Lucboulesteix/TinyRISC/README.md

# TinyRISC
 TINYRISC is a project to design and build an 8-bit computer using discrete logic components
 See "descriptive document.docx" for technical information
