Lucboulesteix/TinyRISC/Diagrams/High level/aludecode.png

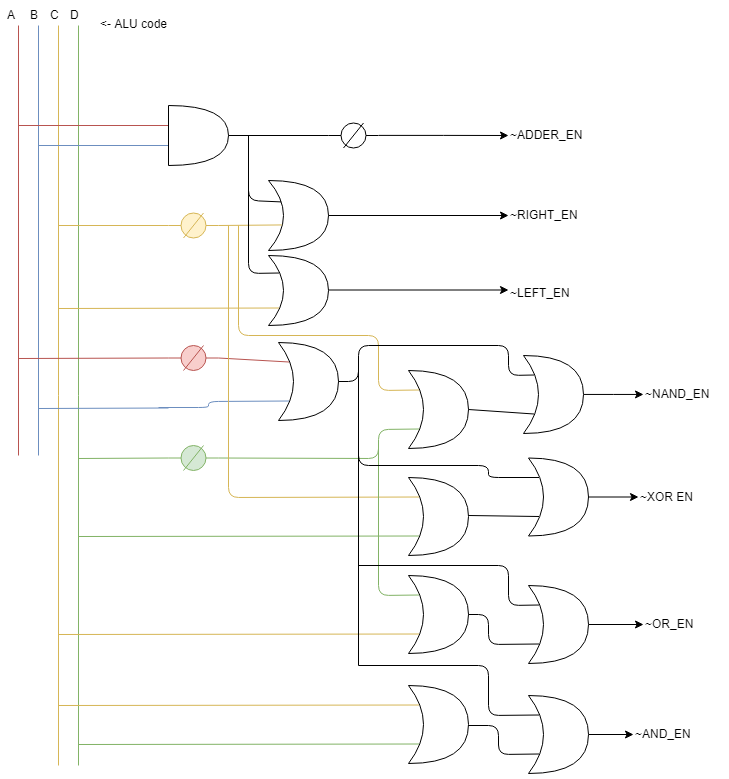
Diagrams/High level/aludecode.png
