Lucboulesteix/TinyRISC/Program Counter/v1.1/Images/PC finished view.png

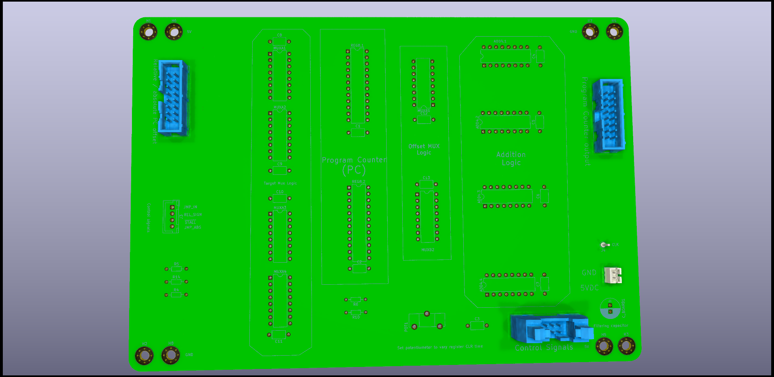
Program Counter/v1.1/Images/PC finished view.png
