Lucboulesteix/TinyRISC/BOM.xlsx

ALU |  | ALU
Id | Designator | Package | Quantity | Designation | Supplier and ref | Bought | Per unit Price | Total price
1 | XOR42,XOR41,XOR4,XOR3,XOR2,XOR1,XOR0 | DIP-14_W7.62mm | 7 | 74F86 | Mouser (https://www.mouser.fr/ProductDetail/Texas-Instruments/SN74F86N?qs=OorDGPQ79EqAoC7T7cW4HA%3D%3D) | 10 | 0.513 | 5.13
2 | 5V/GND1 | JST_XH_B02B-XH-A_02x2.50mm_Straight | 1 | Conn_01x02_Male |  |  |  | 0.00
3 | XOR_GATE0,SR_GATE0,SL_GATE0,OR_GATE1,NAND_GATE0,FlagsRight1,FlagsLogical1,FlagsLeft1,FlagsAdd0,AND_GATE1,ADD_GATE1,ADD_GATE0 | DIP-20_W7.62mm | 12 | 74F245 | Mouser (https://www.mouser.fr/ProductDetail/Texas-Instruments/SN74F245N?qs=p6YqzpSxLIwRRuS%252BxgbuIQ%3D%3D) | 13 | 0.898 | 11.67
4 | PDB15,PDB14,PDB13,PDB12,PDB11,PDB10,PDB9,PDB8,PD15,PD14,PD13,PD12,PD11,PD10,PD9,PD8 | R_Axial_DIN0204_L3.6mm_D1.6mm_P7.62mm_Horizontal | 16 | 10k | https://www.mouser.fr/ProductDetail/YAGEO/CFR-50JR-52-10K | 100 | 0.024 | 2.40
5 | OR1,OR0,DECODEROR0,DECODEOR2,DECODEOR1 | DIP-14_W7.62mm | 5 | 74F32 | Mouser (https://www.mouser.fr/ProductDetail/Texas-Instruments/SN74F32N?qs=mE33ZKBHyE7y%252BJhxkbFiog%3D%3D) | 6 | 0.601 | 3.61
6 | OP2,OP1,ALU_OUT1 | 16pinIDC | 3 | Conn_01x16_Male | Mouser (https://www.mouser.fr/ProductDetail/HARTING/09195167324?qs=Afqhj6cPmO%2FZprUhRABW%252Bw%3D%3D) |  | 2.22 | 0.00
7 | NAND1,NAND0 | DIP-14_W7.62mm | 2 | 74F00 | Mouser (https://www.mouser.fr/ProductDetail/Texas-Instruments/SN74F00N?qs=6gY4t2uohMypkE3htptVwQ%3D%3D) | 3 | 0.559 | 1.68
8 | MUXCout1 | DIP-16_W7.62mm | 1 | 74F257 | https://www.mouser.fr/ProductDetail/Texas-Instruments/SN74F257N?qs=mE33ZKBHyE5hYlcdl%2FU8vg%3D%3D | 8 | 0.69 | 5.52
9 | H8,H7,H6,H4 | MountingHole_3.5mm_Pad_Via | 4 | MountingHole
10 | H5,H3,H2,H1 | MountingHole_3.5mm_Pad_Via | 4 | MountingHole_Pad
11 | FLAGS_OUT1,ALU_COMM1 | 6 pin IDC | 2 | Conn_01x06_Male | https://www.mouser.fr/ProductDetail/HARTING/09185067904?qs=6AJYfC4azShOZEhCahhORg%3D%3D |  | 1.42 | 0.00
12 | DECODENOT0 | DIP-14_W7.62mm | 1 | 74F04 | https://www.mouser.fr/ProductDetail/Texas-Instruments/SN74F04N?qs=sGAEpiMZZMv0NwlthflBiyUjw%252B9sXLI2 | 4 | 0.559 | 2.24
13 | DECODEAND0,AND1,AND0 | DIP-14_W7.62mm | 3 | 74F8 | https://www.mouser.fr/ProductDetail/Texas-Instruments/SN74F08N?qs=sGAEpiMZZMv0NwlthflBi%2FjZjZ8DIWBR | 4 | 0.601 | 2.40
14 | CPOWER1 | CP_Radial_D8.0mm_P2.50mm | 1 | 10uF | https://www.mouser.fr/ProductDetail/Nichicon/URZ1C100MDD1TA?qs=OSAjuGjmRDPZyRhq47BimQ%3D%3D | 4 | 0.305 | 1.22
15 | COMP1 | DIP-20_W7.62mm | 1 | 74F521 | https://www.mouser.fr/ProductDetail/Texas-Instruments/SN74F521N?qs=mE33ZKBHyE77hNjBfZo2rQ%3D%3D | 2 | 0.728 | 1.46
16 | C36,C35,C34,C33,C32,C31,C30,C29,C28,C27,C26,C25,C24,C23,C22,C21,C20,C19,C18,C17,C16,C15,C14,C13,C12,C11,C10,C9,C8,C7,C6,C5,C4,C3,C2,C1 | C_Axial_L5.1mm_D3.1mm_P7.50mm_Horizontal | 36 | 100nF | https://www.mouser.fr/ProductDetail/Vishay-BC-Components/K104M15X7RF53H5?qs=sYfpZ29HcUREF%2FR6EfmLiA%3D%3D | 100 | 0.051 | 5.10
17 | ADD4.3,ADD4.2,ADD4.1,ADD4.0 | DIP-16_W7.62mm | 4 | 74F283 | https://www.mouser.fr/ProductDetail/Texas-Instruments/SN74F283N?qs=RnzODY3cU8vqyMuJt1Bv0A%3D%3D | 6 | 0.822 | 4.93
 |  | IDC16pin ribbon cable |  |  |  |  | 0.601
 |  |  |  |  |  |  | 0.601 | 47.35
 |  | Program Counter |  |  |  |  |  | 42.23
 |  | MountingHole_3.5mm_Pad_Via | 4 | MountingHole_Pad
 |  | MountingHole_3.5mm_Pad_Via | 4 | MountingHole
 |  | C_Axial_L5.1mm_D3.1mm_P7.50mm_Horizontal | 11 | 100nF | See ALU | 100
 |  | C_Axial_L5.1mm_D3.1mm_P7.50mm_Horizontal | 1 | 100nF | See ALU | 100
 |  | C_Axial_L5.1mm_D3.1mm_P7.50mm_Horizontal | 1 | C?
 |  | DIP-24_W7.62mm | 2 | 74F825 | Bought on ebay (will have to check function) | 4
 |  | R_Axial_DIN0204_L3.6mm_D1.6mm_P7.62mm_Horizontal | 4 | 10K
 |  | R_Axial_DIN0204_L3.6mm_D1.6mm_P7.62mm_Horizontal | 1 | 100
 |  | Potentiometer_Trimmer_ACP_CA14h5_Vertical_Px5.0mm_Py10.0mm | 1 | 1K
 |  | DIP-16_W7.62mm | 6 | 74F257 | See ALU | 8
 |  | JST_NV_B02P-NV_2x5.00mm_Vertical | 1 | POWER/GND
 |  | 1pin | 1 | Clock
 |  | JST_XH_B04B-XH-A_04x2.50mm_Straight | 1 | Control
 |  | JST_XH_B16B-XH-A_16x2.50mm_Straight | 1 | PC_OFFS
 |  | JST_XH_B16B-XH-A_16x2.50mm_Straight | 1 | PC_OUT
 |  | CP_Radial_D8.0mm_P2.50mm | 1 | 10uF | See ALU | 4
 |  | DIP-16_W7.62mm | 4 | 74F283 | See ALU | 6
 |  | GP register file
 |  | CP_Radial_D10.0mm_P5.00mm | 1 | 10 uF | See ALU | 4
 |  | Pin_D1.0mm_L10.0mm | 3 | Conn_01x01_Male
 |  | 16pinIDC | 3 | Conn_01x08_Male
 |  | 6pinIDC | 3 | Conn_01x06_Male
 |  | DIP-20_W7.62mm | 14 | 74F573 |  | 15 | 0.68
 |  | DIP-14_W7.62mm | 2 | 74F04 | See ALU | 4
 |  | MountingHole_3.5mm_Pad_Via | 4 | MountingHole_Pad
 |  | MountingHole_3.5mm_Pad_Via | 4 | MountingHole
 |  | DIP-20_W7.62mm | 3 | 74F138 |  | 4
 |  | C_Axial_L5.1mm_D3.1mm_P7.50mm_Horizontal | 17 | 100nF | See ALU | 100
 |  | C_Axial_L5.1mm_D3.1mm_P7.50mm_Horizontal | 2 | 100nf | See ALU | 100
 |  | JST_XH_B2B-XH-AM_1x02_P2.50mm_Vertical | 1 | Conn_01x02_Male
