Lucboulesteix/TinyRISC/Kicad Libraries/NE555DR.stp

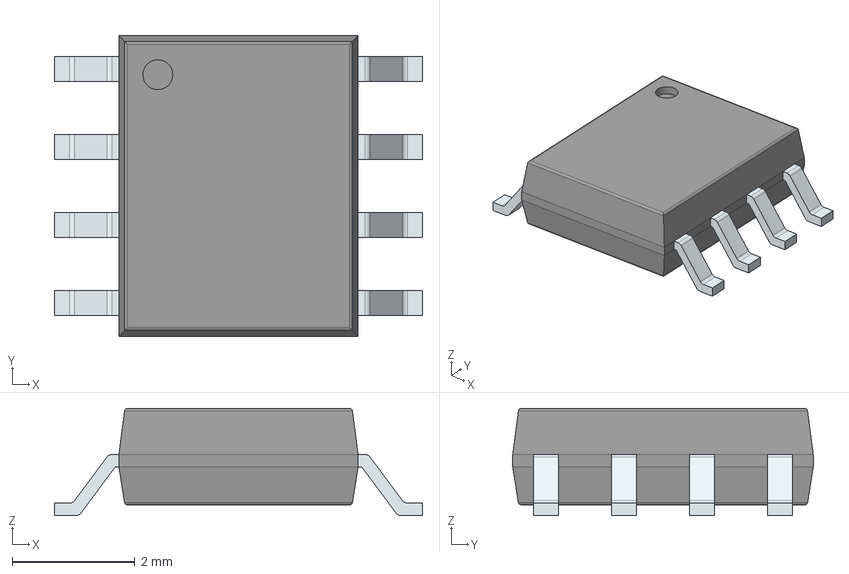
[picture p13: CAD file, 2021-10-25]
Kicad Libraries/NE555DR.stp
6.00 x 4.90 x 1.75 mm
PinsArrayLR
