Lucboulesteix/TinyRISC/Kicad Libraries/09185067904.stp

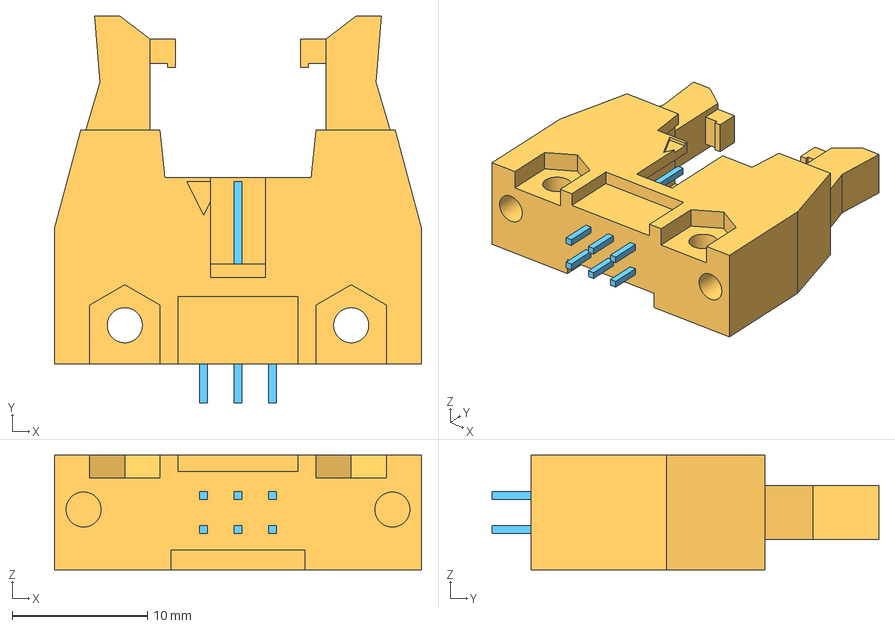
[picture p14: CAD file, 2021-10-25]
Kicad Libraries/09185067904.stp
27.2 x 28.6 x 8.50 mm
