Lucboulesteix/TinyRISC/Kicad Libraries/09185167324.stp

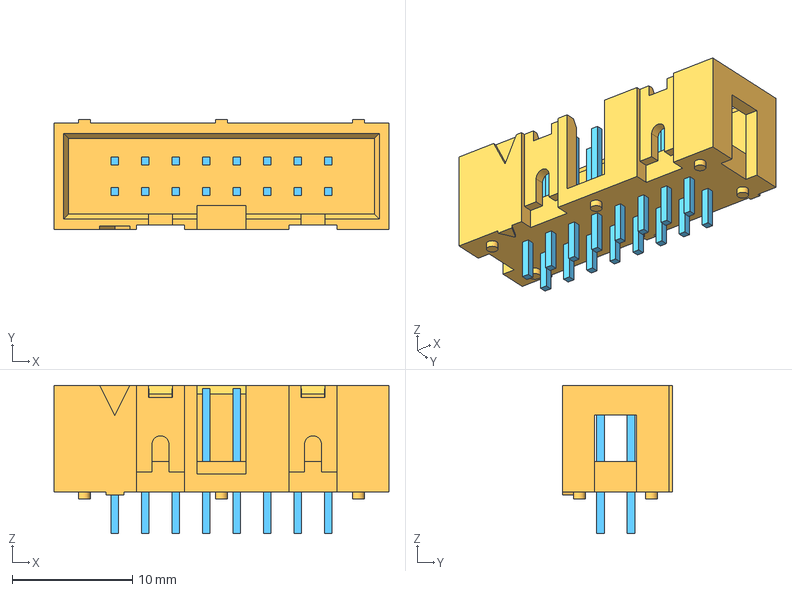
[picture p15: CAD file, 2021-10-25]
Kicad Libraries/09185167324.stp
27.9 x 9.20 x 12.3 mm
