Lucboulesteix/TinyRISC/Instruction syntax.ods

Sheet: Instruction_syntax
bit | 15 | 14 | 13 | 12 | 11 | 10 | 9 | 8 | 7 | 6 | 5 | 4 | 3 | 2 | 1 | 0
R-type | opcode [5] |  |  |  |  | Rd [3] |  |  | Rs[3] |  |  | Ro [3] |  |  | var[2]
I-type | opcode[5] |  |  |  |  | Rd [3] |  |  | Immediate [8]

Sheet: Instruction_control
Instruction | Control signal | OP1 | OP2 | CarryIn | nBit | ALU_COMM | NOTES | PC_OFFS | !STALL | JMP_IN | JMP_ABS | REL_SIGN | NOTES | Write1 | WEN | W1 | R1EN | R1 | R2EN | R2 | NOTE
AND | Rs | Ro | X | X | b100X |  | X | 0 | 0 | 0 | 0 |  | ALU_OUT | 1 | Rd | 1 | Rs | 1 | Ro
OR | Rs | Ro | X | X | b010X |  | X | 0 | 0 | 0 | 0 |  | ALU_OUT | 1 | Rd | 1 | Rs | 1 | Ro
XOR | Rs | Ro | X | X | b101X |  | X | 0 | 0 | 0 | 0 |  | ALU_OUT | 1 | Rd | 1 | Rs | 1 | Ro
NAND | Rs | Ro | X | X | b011X |  | X | 0 | 0 | 0 | 0 |  | ALU_OUT | 1 | Rd | 1 | Rs | 1 | Ro
SHIFT left | Rs | Ro | X | 0 | b0001 |  | X | 0 | 0 | 0 | 0 |  | ALU_OUT | 1 | Rd | 1 | Rs | 0 | X
ROTATE left | Rs | Ro | X | X | b0000 |  | X | 0 | 0 | 0 | 0 |  | ALU_OUT | 1 | Rd | 1 | Rs | 0 | X
SHIFT right | Rs | Ro | X | 0 | b0011 |  | X | 0 | 0 | 0 | 0 |  | ALU_OUT | 1 | Rd | 1 | Rs | 0 | X
ROTATE right | Rs | Ro | X | X | b0010 |  | X | 0 | 0 | 0 | 0 |  | ALU_OUT | 1 | Rd | 1 | Rs | 0 | X
ADD with carry | Rs | Rd | STAT[0] | X | b1100 |  | X | 0 | 0 | 0 | 0
SUBTRACT with carry | Rs | Rd | STAT[0] | X | b1101 |  | X | 0 | 0 | 0 | 0
Increment Register | Rs | CGU (1) | 0 | X | b1100 |  | X | 0 | 0 | 0 | 0
Decrement Register | Rs | CGU (1) | 0 | X | b1101 |  | X | 0 | 0 | 0 | 0
Jump direct | X | X | X | X | X | NO ALU; concatenator | TARGET | 0 | X | 1 | 0
Jump offset register | Rs | 0 | 0 | X | b1100 |  | OFFSET | 0 | 1 | 0 | var[0] | Use care not to use AUX registers as offsets
Jump offset immediate | X | X | X | X | X | NO ALU; implicit | IMM | 0 | 1 | 0 | var[0]
Jump and link | PC | 0 | 0 | X | b1100 | PC routed to LINK | TARGET | 0 | X | 1 | 0
Branch on Carry | X | X | X | X | X | NO ALU; concatenator | TARGET | 0 | 0 | C? | 0 | STAT register state should be bypassed to stage 1
Branch on negative | X | X | X | X | X | NO ALU; concatenator | TARGET | 0 | 0 | N? | 0
Branch on carry and link | PC | 0 | 0 | X | b1100 | PC routed to LINK | TARGET | 0 | 0 | C? | 0
Branch on negative and link | PC | 0 | 0 | X | b1100 | PC routed to LINK | TARGET | 0 | 0 | N? | 0
Branch on overflow | X | X | X | X | X | NO ALU; concatenator | TARGET | 0 | 0 | V? | 0
Branch on overflow and link | PC | 0 | 0 | X | b1100 | PC routed to LINK | TARGET | 0 | 0 | V? | 0
Branch on zero | X | X | X | X | X | NO ALU; concatenator | TARGET | 0 | 0 | Z? | 0
branch on zero and link | PC | 0 | 0 | X | b1100 | PC routed to LINK | TARGET | 0 | 0 | Z? | 0
Load Byte | X | X | X | X | X | No ALU | X | 0 | 0 | 0 | 0
Load Immediate | Imm | 0 | 0 | X | b1100 |  | X | 0 | 0 | 0 | 0
Store Byte | X | X | X | X | X | No ALU | X | 0 | 0 | 0 | 0
Move | Rs | 0 | 0 | X | b1100 |  | X | 0 | 0 | 0 | 0
Pop stack | SP | CGU (1) | 0 | X | b1101 | New SP routed to mem address | X | 0 | 0 | 0 | 0
Push stack | SP | CGU (1) | 0 | X | b1100 | New SP routed to mem address | X | 0 | 0 | 0 | 0
Push stack immediate | SP | CGU (1) | 0 | X | b1100 | New SP routed to mem address | X | 0 | 0 | 0 | 0
No-Op (NOP) | Rs | 0 | 0 | X | b1100 |  | X | 0 | 0 | 0 | 0
Get High Byte | Rs | 0 | 0 | X | b1100 | Shifting handled externally | X | 0 | 0 | 0 | 0
Set High Byte | Rs | 0 | 0 | X | b1100 | Shifting handled externally | X | 0 | 0 | 0 | 0

Sheet: Instruction_listing
 | Instruction name | Instruction class | opcode (dec) | opcode(hex) | Syntax | Desciption | Notes
Logical | AND | R-type | 01 | 1 | Rd = Rs AND Ro | Logical AND |  | 23
 | OR | R-type | 02 | 2 | Rd = Rs OR Ro | Logical OR |  | 28
 | XOR | R-type | 03 | 3 | Rd = Rs XOR Ro | Logical XOR
 | NAND | R-type | 04 | 4 | Rd = Rs NAND Ro | Logical XOR
 | SHIFT left | R-type | 05 | 5 | Rd = Rs << Ro | left shift
 | ROTATE left | R-type | 07 | 7 | Rd = Rs ROTL Ro | left rotate (wraparound)
 | SHIFT right | R-type | 06 | 6 | Rd = Rs >> Ro | right shift
 | ROTATE right | R-type | 08 | 8 | Rd = Rs ROTR | right rotate (wraparound)
Math | ADD with carry | R-type | 09 | 9 | Rd = Rs + Ro + C | Adds two numbers with carry-in
 | SUBTRACT with carry | R-type | 10 | A | Rd = Rs - Ro - NOT(C) | subtracts two numbers with borrow
 | Increment Register | R-type | 11 | B | Rd = Rs+1
 | Decrement Register | R-type | 13 | D | Rd = Rs-1
Jump | Jump direct | R-type | 19 | 13 |  | Directs PC to address in register
 | Jump offset register | R-type | 20 | 14 |  | Directs PC to itself + register
 | Jump offset immediate | I-type | 21 | 15 |  | Directs PC to itself + immediate
 | Jump and link | R-type | 22 | 16 |  | Directs PC to address in register and loads last PC onto stack | See section of subroutine calls and consequence on PC
Branch | Branch on Carry | R-type | 16 | 10 |  | If carry flag == 1, branch to address in register
 | Branch on negative | R-type | 17 | 11 |  | If negative flag == 1, branch to address in register
 | Branch on carry and link | R-type | 24 | 18 |  | If carry flag == 1, branch to address in register and load last PC onto stack | See section of subroutine calls and consequence on PC
 | Branch on negative and link | R-type | 25 | 19 |  | If negative flag == 1, branch to address in register and load last PC onto stack | See section of subroutine calls and consequence on PC
 | Branch on overflow | R-type | 19 | 13
 | Branch on overflow and link | R-type | 27 | 1B
 | Branch on zero | R-type | 18 | 12 |  | If zero flag == 1, branch to address in register
 | branch on zero and link | R-type | 26 | 1A |  | If carry flag == 1, branch to address in register and load last PC onto stack | See section of subroutine calls and consequence on PC
Memory | Load Byte | R-type | 29 | 1D |  | Loads byte from memory address in register to register | See section on memory addressing
 | Load Immediate | I-type | 30 | 1E |  | Load immediate value to register
 | Store Byte | R-type | 31 | 1F |  | Stores value in operator register to memory address in source register | See section on memory addressing
 | Move | R-type | 00 | 0 |  | Moves value between two registers
Stack | Pop stack | R-type | 12 | C |  | Decrements SP | See sections on stack operation
 | Push stack | R-type | 13 | D |  | Increments SP and and stores value in register into stack
 | Push stack immediate | I-type | 14 | E |  | Increments SP and and stores immediate value into stack
Misc | No-Op (NOP) | R-type | 00 | 0 |  | Performs no operation | Encoded as a data move with source as destination -> no net effect
 | Get High Byte | R-type | 23 | 17 |  | Moves Highest-order byte of operand register to destination register. For use with 16-bit registers such as SP or LINK.
 | Set High Byte | R-type | 28 | 1C |  | Sets Highest Order byte of destination register to match the contents of operand register. For use with 16-bit registers such as SP or LINK.

Sheet: Registers
Register | ID | Width (bits)
GP0 | 0 | 8 |  | Note
GP1 | 1 | 8 |  | A note on accessing registers: if attempting to access registers other than GP registers, you will need to supply an additionnal register sub-ID in the "var" field. Accessing these registers MAY result in a stall for a few cycles depending on width.
GP2 | 2 | 8
GP3 | 3 | 8
GP4 | 4 | 8
GP5 | 5 | 8
GP6 | 6 | 8
AUX | 7
LINK register | var = b00 | 16
 |  |  | Status Register Structure
Stack Pointer | var = b10 | 16
 |  |  | bit | 7 | 6 | 5 | 4 | 3 | 2 | 1 | 0
Status Register | var = b01 | 8 |  | Interrupts Masked |  |  |  | Overflow (V) | Negative (N) | Zero (Z) | Carry (C)
MEM Register | var = b11 | 8

Sheet: ALU_command_codes
Operation | Code (binary) | Operation | Code (binary)
Rotate left | b0000 | AND | b100X
Shift left | b0001 | OR | b010X
Rotate Right | b0010 | XOR | b101X
Shift Right | b0011 | NAND | b011X
Add with C | b1100
Subtract with C | b1101
