Lucboulesteix/TinyRISC/Program Counter/v1.1/Changes and fixes.txt

vs. v1.0:

-connected register output to adder input
