Lucboulesteix/TinyRISC/(list of files, drawings)

Other design files:
ALU/ALU/ALU_final_v1.dsn
GPRegister File/General Purpose RF/GRPFv1.dsn
Logisim/ALu decoder.circ
Program Counter/v1.1/Program Counter.dsn
