Lucboulesteix/TinyRISC/GPRegister File/General Purpose RF/General Purpose RF.kicad_pcb

## KiCad design GPRegister File/General Purpose RF/General Purpose RF.kicad_pcb (2021-10-27)

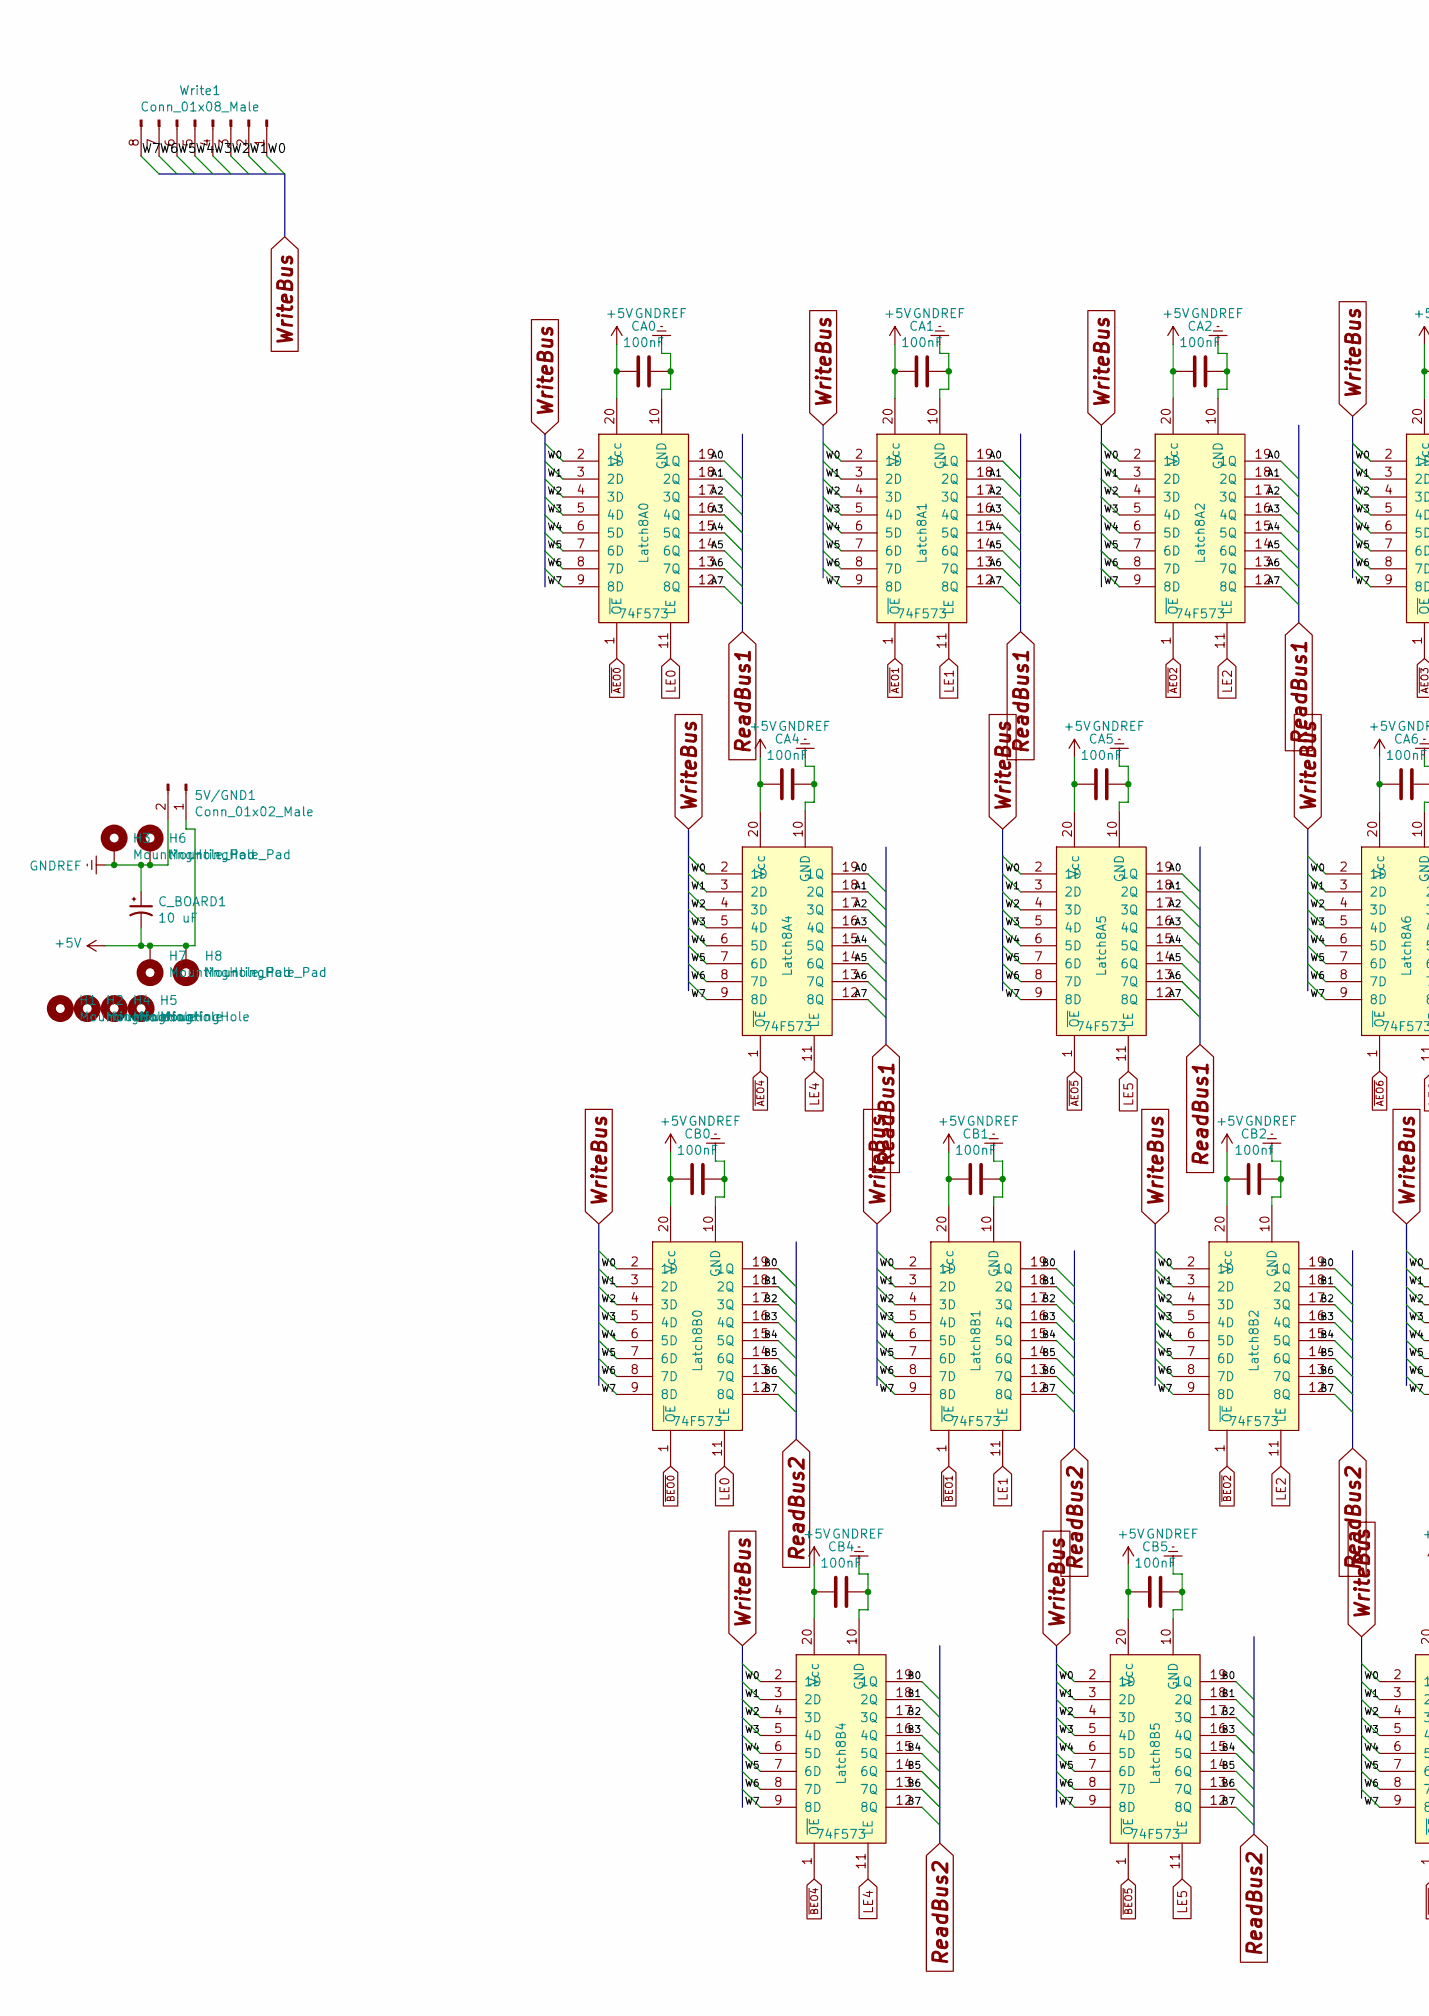
[picture p16: schematic General Purpose RF.sch, TinyRISC General Purpose Register File, part in row 1, column 1]

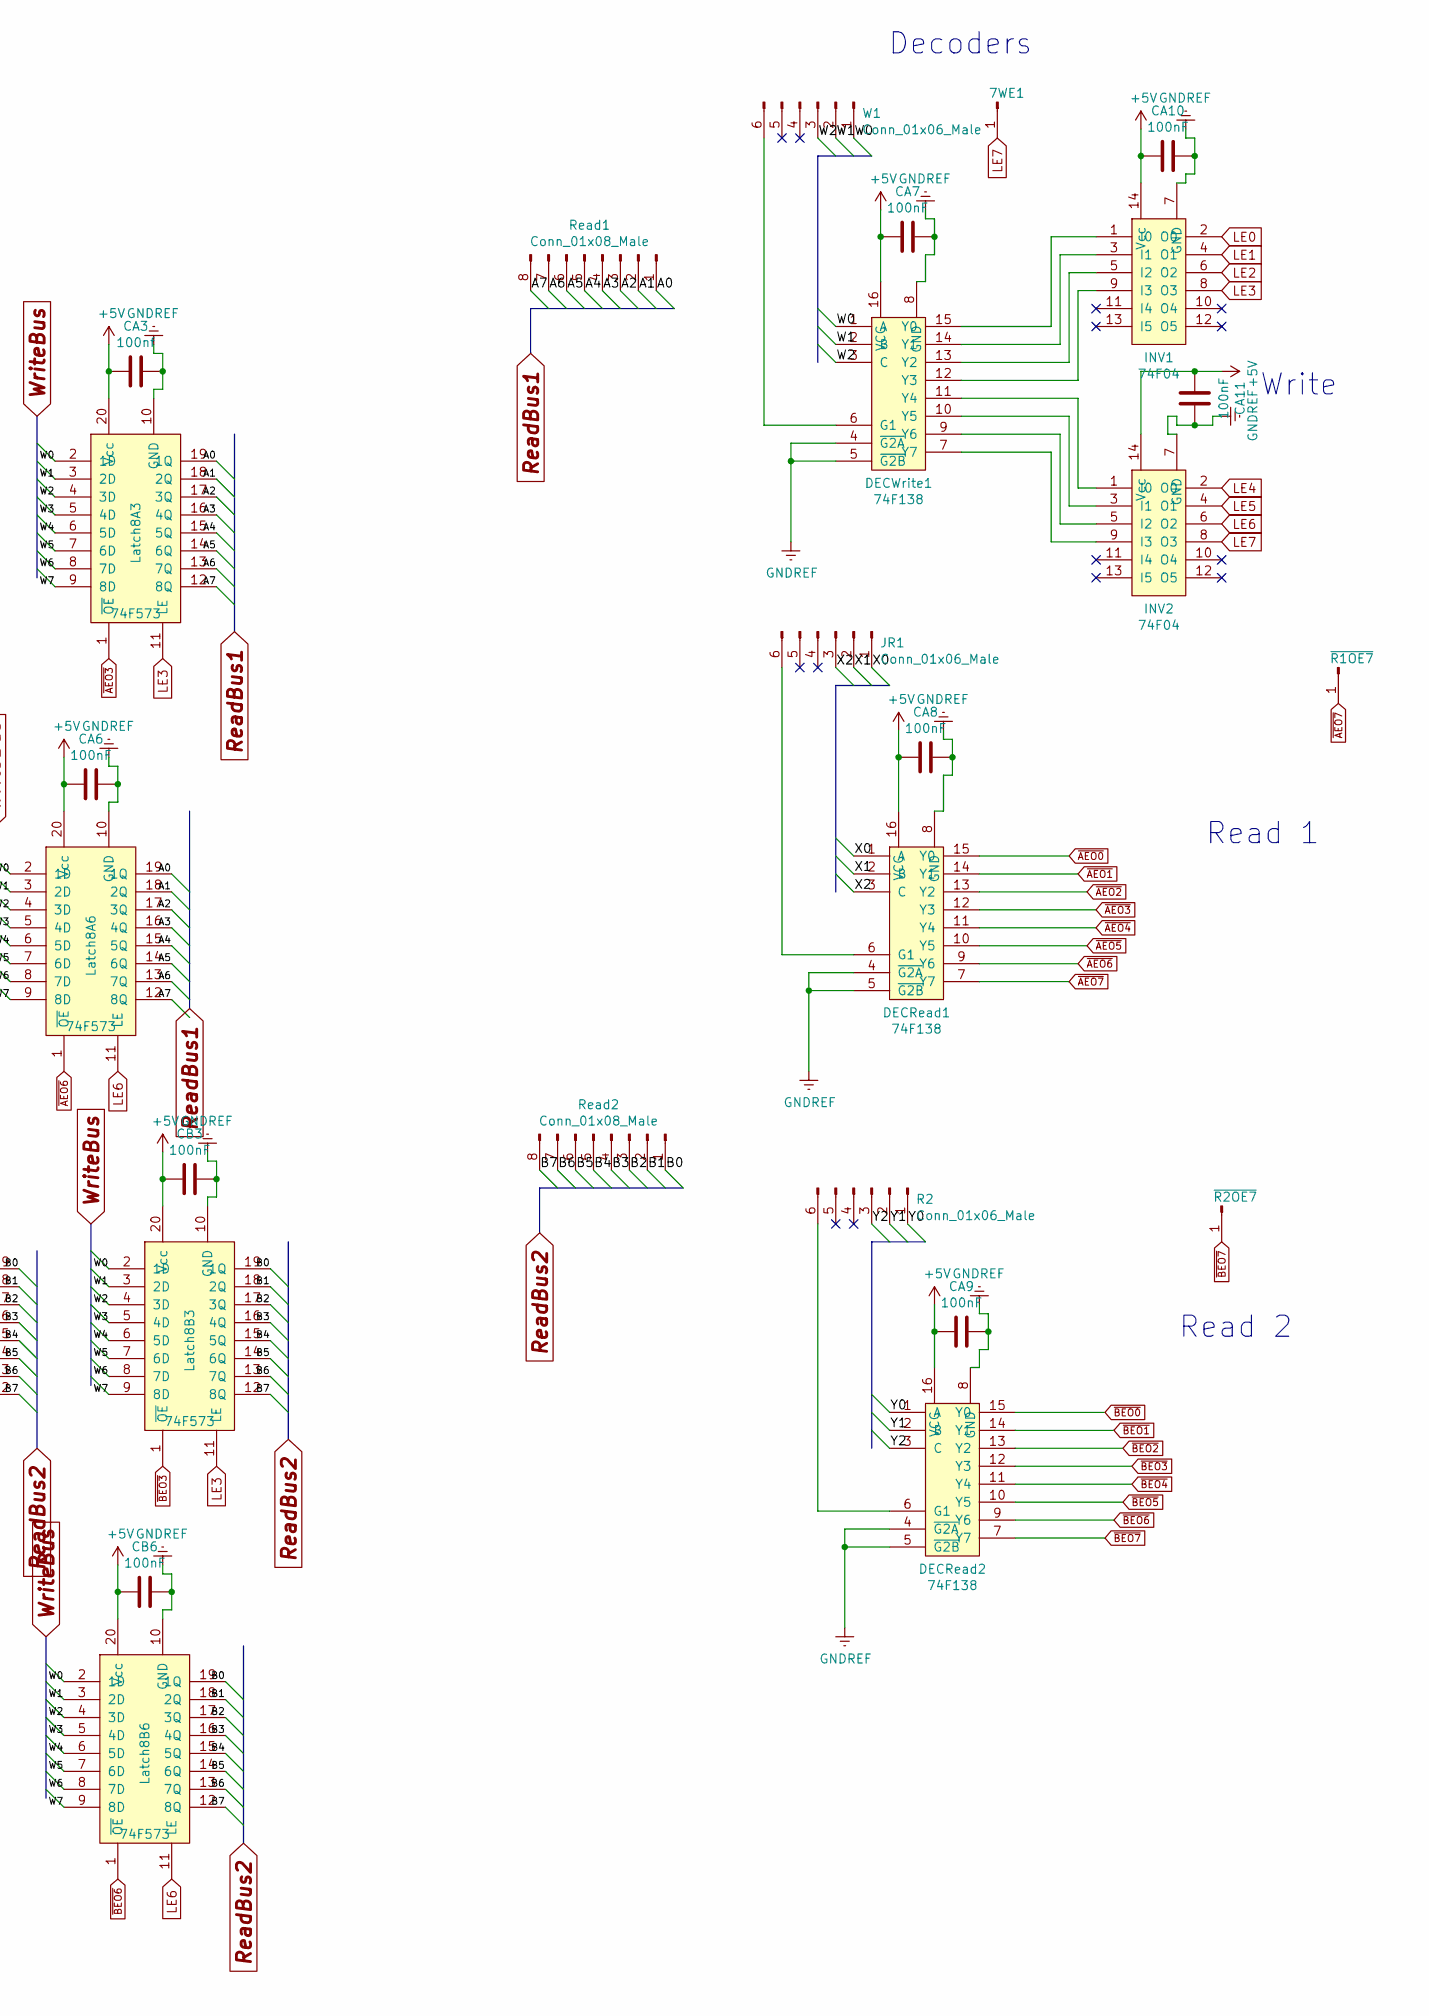
[picture p17: schematic General Purpose RF.sch, TinyRISC General Purpose Register File, part in row 1, column 2]

Parts:
5V/GND1: Conn_01x02_Male; JST_XH_B2B-XH-AM_1x02_P2.50mm_Vertical
7WE1: Conn_01x01_Male; Pin_D1.0mm_L10.0mm
CA0, CA1, CA2, CA4, CA5, CA6, CA7, CA8, CA9, CA10, CA11: 100nF; C_Axial_L5.1mm_D3.1mm_P7.50mm_Horizontal
CA3: 100nf; C_Axial_L5.1mm_D3.1mm_P7.50mm_Horizontal
CB0, CB1, CB3, CB4, CB5, CB6: 100nF; C_Axial_L5.1mm_D3.1mm_P7.50mm_Horizontal
CB2: 100nf; C_Axial_L5.1mm_D3.1mm_P7.50mm_Horizontal
C_BOARD1: 10 uF; CP_Radial_D10.0mm_P5.00mm
DECRead1, DECRead2: 74F138; DIP-20_W7.62mm
DECWrite1: 74F138; DIP-20_W7.62mm
H1, H2, H4, H5: MountingHole; MountingHole_3.5mm_Pad_Via
H3, H6, H7, H8: MountingHole_Pad; MountingHole_3.5mm_Pad_Via
INV1, INV2: 74F04; DIP-14_W7.62mm
JR1: Conn_01x06_Male; 6pinIDC
Latch8A0, Latch8A1, Latch8A2, Latch8A3, Latch8A4, Latch8A5, Latch8A6, Latch8B0, Latch8B1, Latch8B2, Latch8B3, Latch8B4, Latch8B5, Latch8B6: 74F573; DIP-20_W7.62mm
R2: Conn_01x06_Male; 6pinIDC
Read1, Read2: Conn_01x08_Male; 16pinIDC
W1: Conn_01x06_Male; 6pinIDC
Write1: Conn_01x08_Male; 16pinIDC
~R1OE7, ~R2OE7: Conn_01x01_Male; Pin_D1.0mm_L10.0mm

Connections:
+5V: 5V/GND1.1, CA0.1, CA1.1, CA2.1, CA3.1, CA4.1, CA5.1, CA6.1, CA7.1, CA8.1, CA9.1, CA10.1, CA11.1, CB0.1, CB1.1, CB2.1, CB3.1, CB4.1, CB5.1, CB6.1, C_BOARD1.2, DECRead1.16 (VCC), DECRead2.16 (VCC), DECWrite1.16 (VCC), H7.1, H8.1, INV1.14 (Vcc), INV2.14 (Vcc), Latch8A0.20 (Vcc), Latch8A1.20 (Vcc), Latch8A2.20 (Vcc), Latch8A3.20 (Vcc), Latch8A4.20 (Vcc), Latch8A5.20 (Vcc), Latch8A6.20 (Vcc), Latch8B0.20 (Vcc), Latch8B1.20 (Vcc), Latch8B2.20 (Vcc), Latch8B3.20 (Vcc), Latch8B4.20 (Vcc), Latch8B5.20 (Vcc), Latch8B6.20 (Vcc)
/A0: Latch8A0.19 (1Q), Latch8A1.19 (1Q), Latch8A2.19 (1Q), Latch8A3.19 (1Q), Latch8A4.19 (1Q), Latch8A5.19 (1Q), Latch8A6.19 (1Q), Read1.1
/A1: Latch8A0.18 (2Q), Latch8A1.18 (2Q), Latch8A2.18 (2Q), Latch8A3.18 (2Q), Latch8A4.18 (2Q), Latch8A5.18 (2Q), Latch8A6.18 (2Q), Read1.2
/A2: Latch8A0.17 (3Q), Latch8A1.17 (3Q), Latch8A2.17 (3Q), Latch8A3.17 (3Q), Latch8A4.17 (3Q), Latch8A5.17 (3Q), Latch8A6.17 (3Q), Read1.3
/A3: Latch8A0.16 (4Q), Latch8A1.16 (4Q), Latch8A2.16 (4Q), Latch8A3.16 (4Q), Latch8A4.16 (4Q), Latch8A5.16 (4Q), Latch8A6.16 (4Q), Read1.4
/A4: Latch8A0.15 (5Q), Latch8A1.15 (5Q), Latch8A2.15 (5Q), Latch8A3.15 (5Q), Latch8A4.15 (5Q), Latch8A5.15 (5Q), Latch8A6.15 (5Q), Read1.5
/A5: Latch8A0.14 (6Q), Latch8A1.14 (6Q), Latch8A2.14 (6Q), Latch8A3.14 (6Q), Latch8A4.14 (6Q), Latch8A5.14 (6Q), Latch8A6.14 (6Q), Read1.6
/A6: Latch8A0.13 (7Q), Latch8A1.13 (7Q), Latch8A2.13 (7Q), Latch8A3.13 (7Q), Latch8A4.13 (7Q), Latch8A5.13 (7Q), Latch8A6.13 (7Q), Read1.7
/A7: Latch8A0.12 (8Q), Latch8A1.12 (8Q), Latch8A2.12 (8Q), Latch8A3.12 (8Q), Latch8A4.12 (8Q), Latch8A5.12 (8Q), Latch8A6.12 (8Q), Read1.8
/B0: Latch8B0.19 (1Q), Latch8B1.19 (1Q), Latch8B2.19 (1Q), Latch8B3.19 (1Q), Latch8B4.19 (1Q), Latch8B5.19 (1Q), Latch8B6.19 (1Q), Read2.1
/B1: Latch8B0.18 (2Q), Latch8B1.18 (2Q), Latch8B2.18 (2Q), Latch8B3.18 (2Q), Latch8B4.18 (2Q), Latch8B5.18 (2Q), Latch8B6.18 (2Q), Read2.2
/B2: Latch8B0.17 (3Q), Latch8B1.17 (3Q), Latch8B2.17 (3Q), Latch8B3.17 (3Q), Latch8B4.17 (3Q), Latch8B5.17 (3Q), Latch8B6.17 (3Q), Read2.3
/B3: Latch8B0.16 (4Q), Latch8B1.16 (4Q), Latch8B2.16 (4Q), Latch8B3.16 (4Q), Latch8B4.16 (4Q), Latch8B5.16 (4Q), Latch8B6.16 (4Q), Read2.4
/B4: Latch8B0.15 (5Q), Latch8B1.15 (5Q), Latch8B2.15 (5Q), Latch8B3.15 (5Q), Latch8B4.15 (5Q), Latch8B5.15 (5Q), Latch8B6.15 (5Q), Read2.5
/B5: Latch8B0.14 (6Q), Latch8B1.14 (6Q), Latch8B2.14 (6Q), Latch8B3.14 (6Q), Latch8B4.14 (6Q), Latch8B5.14 (6Q), Latch8B6.14 (6Q), Read2.6
/B6: Latch8B0.13 (7Q), Latch8B1.13 (7Q), Latch8B2.13 (7Q), Latch8B3.13 (7Q), Latch8B4.13 (7Q), Latch8B5.13 (7Q), Latch8B6.13 (7Q), Read2.7
/B7: Latch8B0.12 (8Q), Latch8B1.12 (8Q), Latch8B2.12 (8Q), Latch8B3.12 (8Q), Latch8B4.12 (8Q), Latch8B5.12 (8Q), Latch8B6.12 (8Q), Read2.8
/W0: DECWrite1.1 (A), Latch8A0.2 (1D), Latch8A1.2 (1D), Latch8A2.2 (1D), Latch8A3.2 (1D), Latch8A4.2 (1D), Latch8A5.2 (1D), Latch8A6.2 (1D), Latch8B0.2 (1D), Latch8B1.2 (1D), Latch8B2.2 (1D), Latch8B3.2 (1D), Latch8B4.2 (1D), Latch8B5.2 (1D), Latch8B6.2 (1D), W1.1, Write1.1
/W1: DECWrite1.2 (B), Latch8A0.3 (2D), Latch8A1.3 (2D), Latch8A2.3 (2D), Latch8A3.3 (2D), Latch8A4.3 (2D), Latch8A5.3 (2D), Latch8A6.3 (2D), Latch8B0.3 (2D), Latch8B1.3 (2D), Latch8B2.3 (2D), Latch8B3.3 (2D), Latch8B4.3 (2D), Latch8B5.3 (2D), Latch8B6.3 (2D), W1.2, Write1.2
/W2: DECWrite1.3 (C), Latch8A0.4 (3D), Latch8A1.4 (3D), Latch8A2.4 (3D), Latch8A3.4 (3D), Latch8A4.4 (3D), Latch8A5.4 (3D), Latch8A6.4 (3D), Latch8B0.4 (3D), Latch8B1.4 (3D), Latch8B2.4 (3D), Latch8B3.4 (3D), Latch8B4.4 (3D), Latch8B5.4 (3D), Latch8B6.4 (3D), W1.3, Write1.3
/W3: Latch8A0.5 (4D), Latch8A1.5 (4D), Latch8A2.5 (4D), Latch8A3.5 (4D), Latch8A4.5 (4D), Latch8A5.5 (4D), Latch8A6.5 (4D), Latch8B0.5 (4D), Latch8B1.5 (4D), Latch8B2.5 (4D), Latch8B3.5 (4D), Latch8B4.5 (4D), Latch8B5.5 (4D), Latch8B6.5 (4D), Write1.4
/W4: Latch8A0.6 (5D), Latch8A1.6 (5D), Latch8A2.6 (5D), Latch8A3.6 (5D), Latch8A4.6 (5D), Latch8A5.6 (5D), Latch8A6.6 (5D), Latch8B0.6 (5D), Latch8B1.6 (5D), Latch8B2.6 (5D), Latch8B3.6 (5D), Latch8B4.6 (5D), Latch8B5.6 (5D), Latch8B6.6 (5D), Write1.5
/W5: Latch8A0.7 (6D), Latch8A1.7 (6D), Latch8A2.7 (6D), Latch8A3.7 (6D), Latch8A4.7 (6D), Latch8A5.7 (6D), Latch8A6.7 (6D), Latch8B0.7 (6D), Latch8B1.7 (6D), Latch8B2.7 (6D), Latch8B3.7 (6D), Latch8B4.7 (6D), Latch8B5.7 (6D), Latch8B6.7 (6D), Write1.6
/W6: Latch8A0.8 (7D), Latch8A1.8 (7D), Latch8A2.8 (7D), Latch8A3.8 (7D), Latch8A4.8 (7D), Latch8A5.8 (7D), Latch8A6.8 (7D), Latch8B0.8 (7D), Latch8B1.8 (7D), Latch8B2.8 (7D), Latch8B3.8 (7D), Latch8B4.8 (7D), Latch8B5.8 (7D), Latch8B6.8 (7D), Write1.7
/W7: Latch8A0.9 (8D), Latch8A1.9 (8D), Latch8A2.9 (8D), Latch8A3.9 (8D), Latch8A4.9 (8D), Latch8A5.9 (8D), Latch8A6.9 (8D), Latch8B0.9 (8D), Latch8B1.9 (8D), Latch8B2.9 (8D), Latch8B3.9 (8D), Latch8B4.9 (8D), Latch8B5.9 (8D), Latch8B6.9 (8D), Write1.8
/X0: DECRead1.1 (A), JR1.1; also elsewhere on the board
/X1: DECRead1.2 (B), JR1.2; also elsewhere on the board
/X2: DECRead1.3 (C), JR1.3; also elsewhere on the board
/Y0: DECRead2.1 (A), R2.1; also elsewhere on the board
/Y1: DECRead2.2 (B), R2.2; also elsewhere on the board
/Y2: DECRead2.3 (C), R2.3; also elsewhere on the board
GNDREF: 5V/GND1.2, CA0.2, CA1.2, CA2.2, CA3.2, CA4.2, CA5.2, CA6.2, CA7.2, CA8.2, CA9.2, CA10.2, CA11.2, CB0.2, CB1.2, CB2.2, CB3.2, CB4.2, CB5.2, CB6.2, C_BOARD1.1, DECRead1.4 (~G2A), DECRead1.5 (~G2B), DECRead1.8 (GND), DECRead2.4 (~G2A), DECRead2.5 (~G2B), DECRead2.8 (GND), DECWrite1.4 (~G2A), DECWrite1.5 (~G2B), DECWrite1.8 (GND), H3.1, H6.1, INV1.7 (GND), INV2.7 (GND), Latch8A0.10 (GND), Latch8A1.10 (GND), Latch8A2.10 (GND), Latch8A3.10 (GND), Latch8A4.10 (GND), Latch8A5.10 (GND), Latch8A6.10 (GND), Latch8B0.10 (GND), Latch8B1.10 (GND), Latch8B2.10 (GND), Latch8B3.10 (GND), Latch8B4.10 (GND), Latch8B5.10 (GND), Latch8B6.10 (GND)
LE0: INV1.2 (O0), Latch8A0.11 (LE), Latch8B0.11 (LE)
LE1: INV1.4 (O1), Latch8A1.11 (LE), Latch8B1.11 (LE)
LE2: INV1.6 (O2), Latch8A2.11 (LE), Latch8B2.11 (LE)
LE3: INV1.8 (O3), Latch8A3.11 (LE), Latch8B3.11 (LE)
LE4: INV2.2 (O0), Latch8A4.11 (LE), Latch8B4.11 (LE)
LE5: INV2.4 (O1), Latch8A5.11 (LE), Latch8B5.11 (LE)
LE6: INV2.6 (O2), Latch8A6.11 (LE), Latch8B6.11 (LE)
LE7: 7WE1.1, INV2.8 (O3)
unnamed 40: DECRead1.6 (G1), JR1.6; also elsewhere on the board
unnamed 41: DECRead2.6 (G1), R2.6; also elsewhere on the board
unnamed: DECWrite1.6 (G1), W1.6
unnamed: DECWrite1.7 (Y7), INV2.9 (I3)
unnamed: DECWrite1.9 (Y6), INV2.5 (I2)
unnamed: DECWrite1.10 (Y5), INV2.3 (I1)
unnamed: DECWrite1.11 (Y4), INV2.1 (I0)
unnamed: DECWrite1.12 (Y3), INV1.9 (I3)
unnamed: DECWrite1.13 (Y2), INV1.5 (I2)
unnamed: DECWrite1.14 (Y1), INV1.3 (I1)
unnamed: DECWrite1.15 (Y0), INV1.1 (I0)
~AEO0: DECRead1.15 (Y0), Latch8A0.1 (~OE)
~AEO1: DECRead1.14 (Y1), Latch8A1.1 (~OE)
~AEO2: DECRead1.13 (Y2), Latch8A2.1 (~OE)
~AEO3: DECRead1.12 (Y3), Latch8A3.1 (~OE)
~AEO4: DECRead1.11 (Y4), Latch8A4.1 (~OE)
~AEO5: DECRead1.10 (Y5), Latch8A5.1 (~OE)
~AEO6: DECRead1.9 (Y6), Latch8A6.1 (~OE)
~AEO7: DECRead1.7 (Y7), ~R1OE7.1
~BEO0: DECRead2.15 (Y0), Latch8B0.1 (~OE)
~BEO1: DECRead2.14 (Y1), Latch8B1.1 (~OE)
~BEO2: DECRead2.13 (Y2), Latch8B2.1 (~OE)
~BEO3: DECRead2.12 (Y3), Latch8B3.1 (~OE)
~BEO4: DECRead2.11 (Y4), Latch8B4.1 (~OE)
~BEO5: DECRead2.10 (Y5), Latch8B5.1 (~OE)
~BEO6: DECRead2.9 (Y6), Latch8B6.1 (~OE)
~BEO7: DECRead2.7 (Y7), ~R2OE7.1

Notes on the sheet:
Decoders
Write
Read 1
Read 2

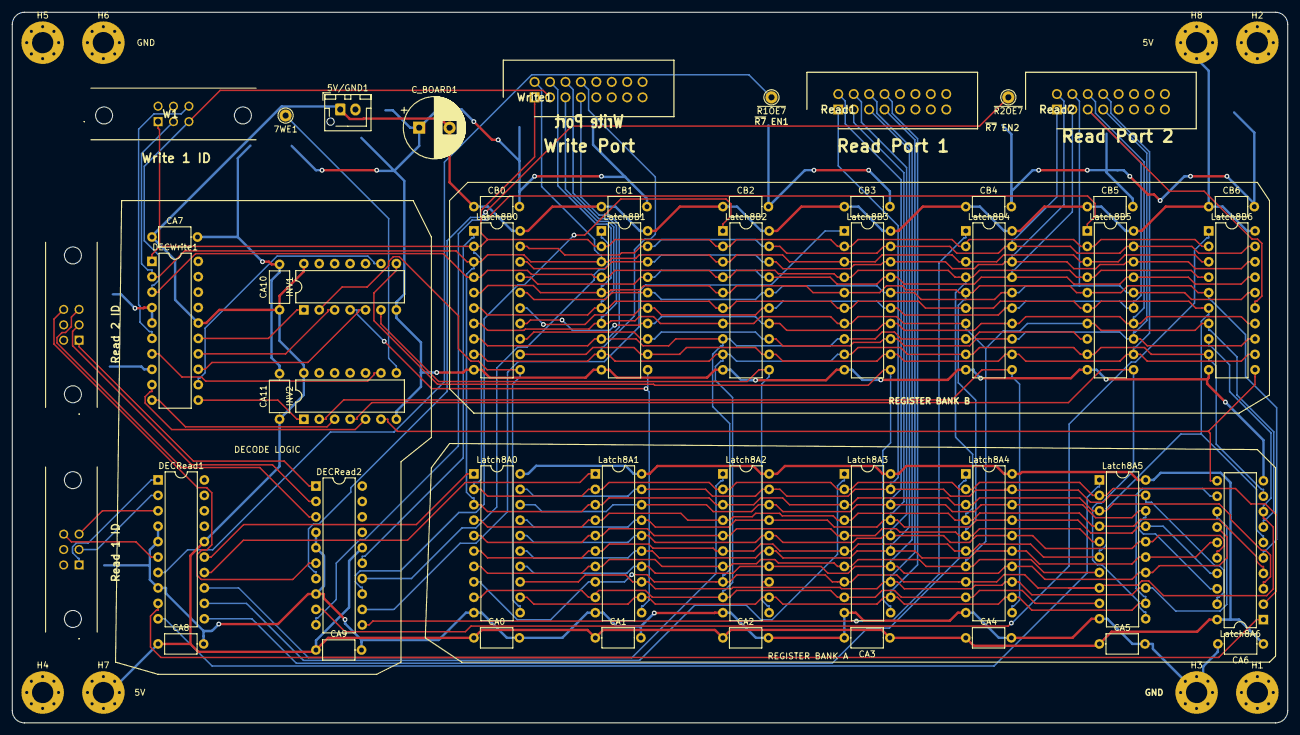
[picture p18: board General Purpose RF.kicad_pcb from above]

Board: 2 copper layers, 210.0 x 117.0 mm, 55 parts (0 on the bottom side), 65 nets.

Other parts of the board:
Read 1 ID, Read 2 ID: Conn_01x06_Male; 6pinIDC

Their connections:
/X0: Read 1 ID.1; also elsewhere on the board
/X1: Read 1 ID.2; also elsewhere on the board
/X2: Read 1 ID.3; also elsewhere on the board
/Y0: Read 2 ID.1; also elsewhere on the board
/Y1: Read 2 ID.2; also elsewhere on the board
/Y2: Read 2 ID.3; also elsewhere on the board
unnamed 40: Read 1 ID.6; also elsewhere on the board
unnamed 41: Read 2 ID.6; also elsewhere on the board
