Lucboulesteix/TinyRISC/ALU/ALU/ALU.kicad_pcb

## KiCad design ALU/ALU/ALU.kicad_pcb (2021-10-27)

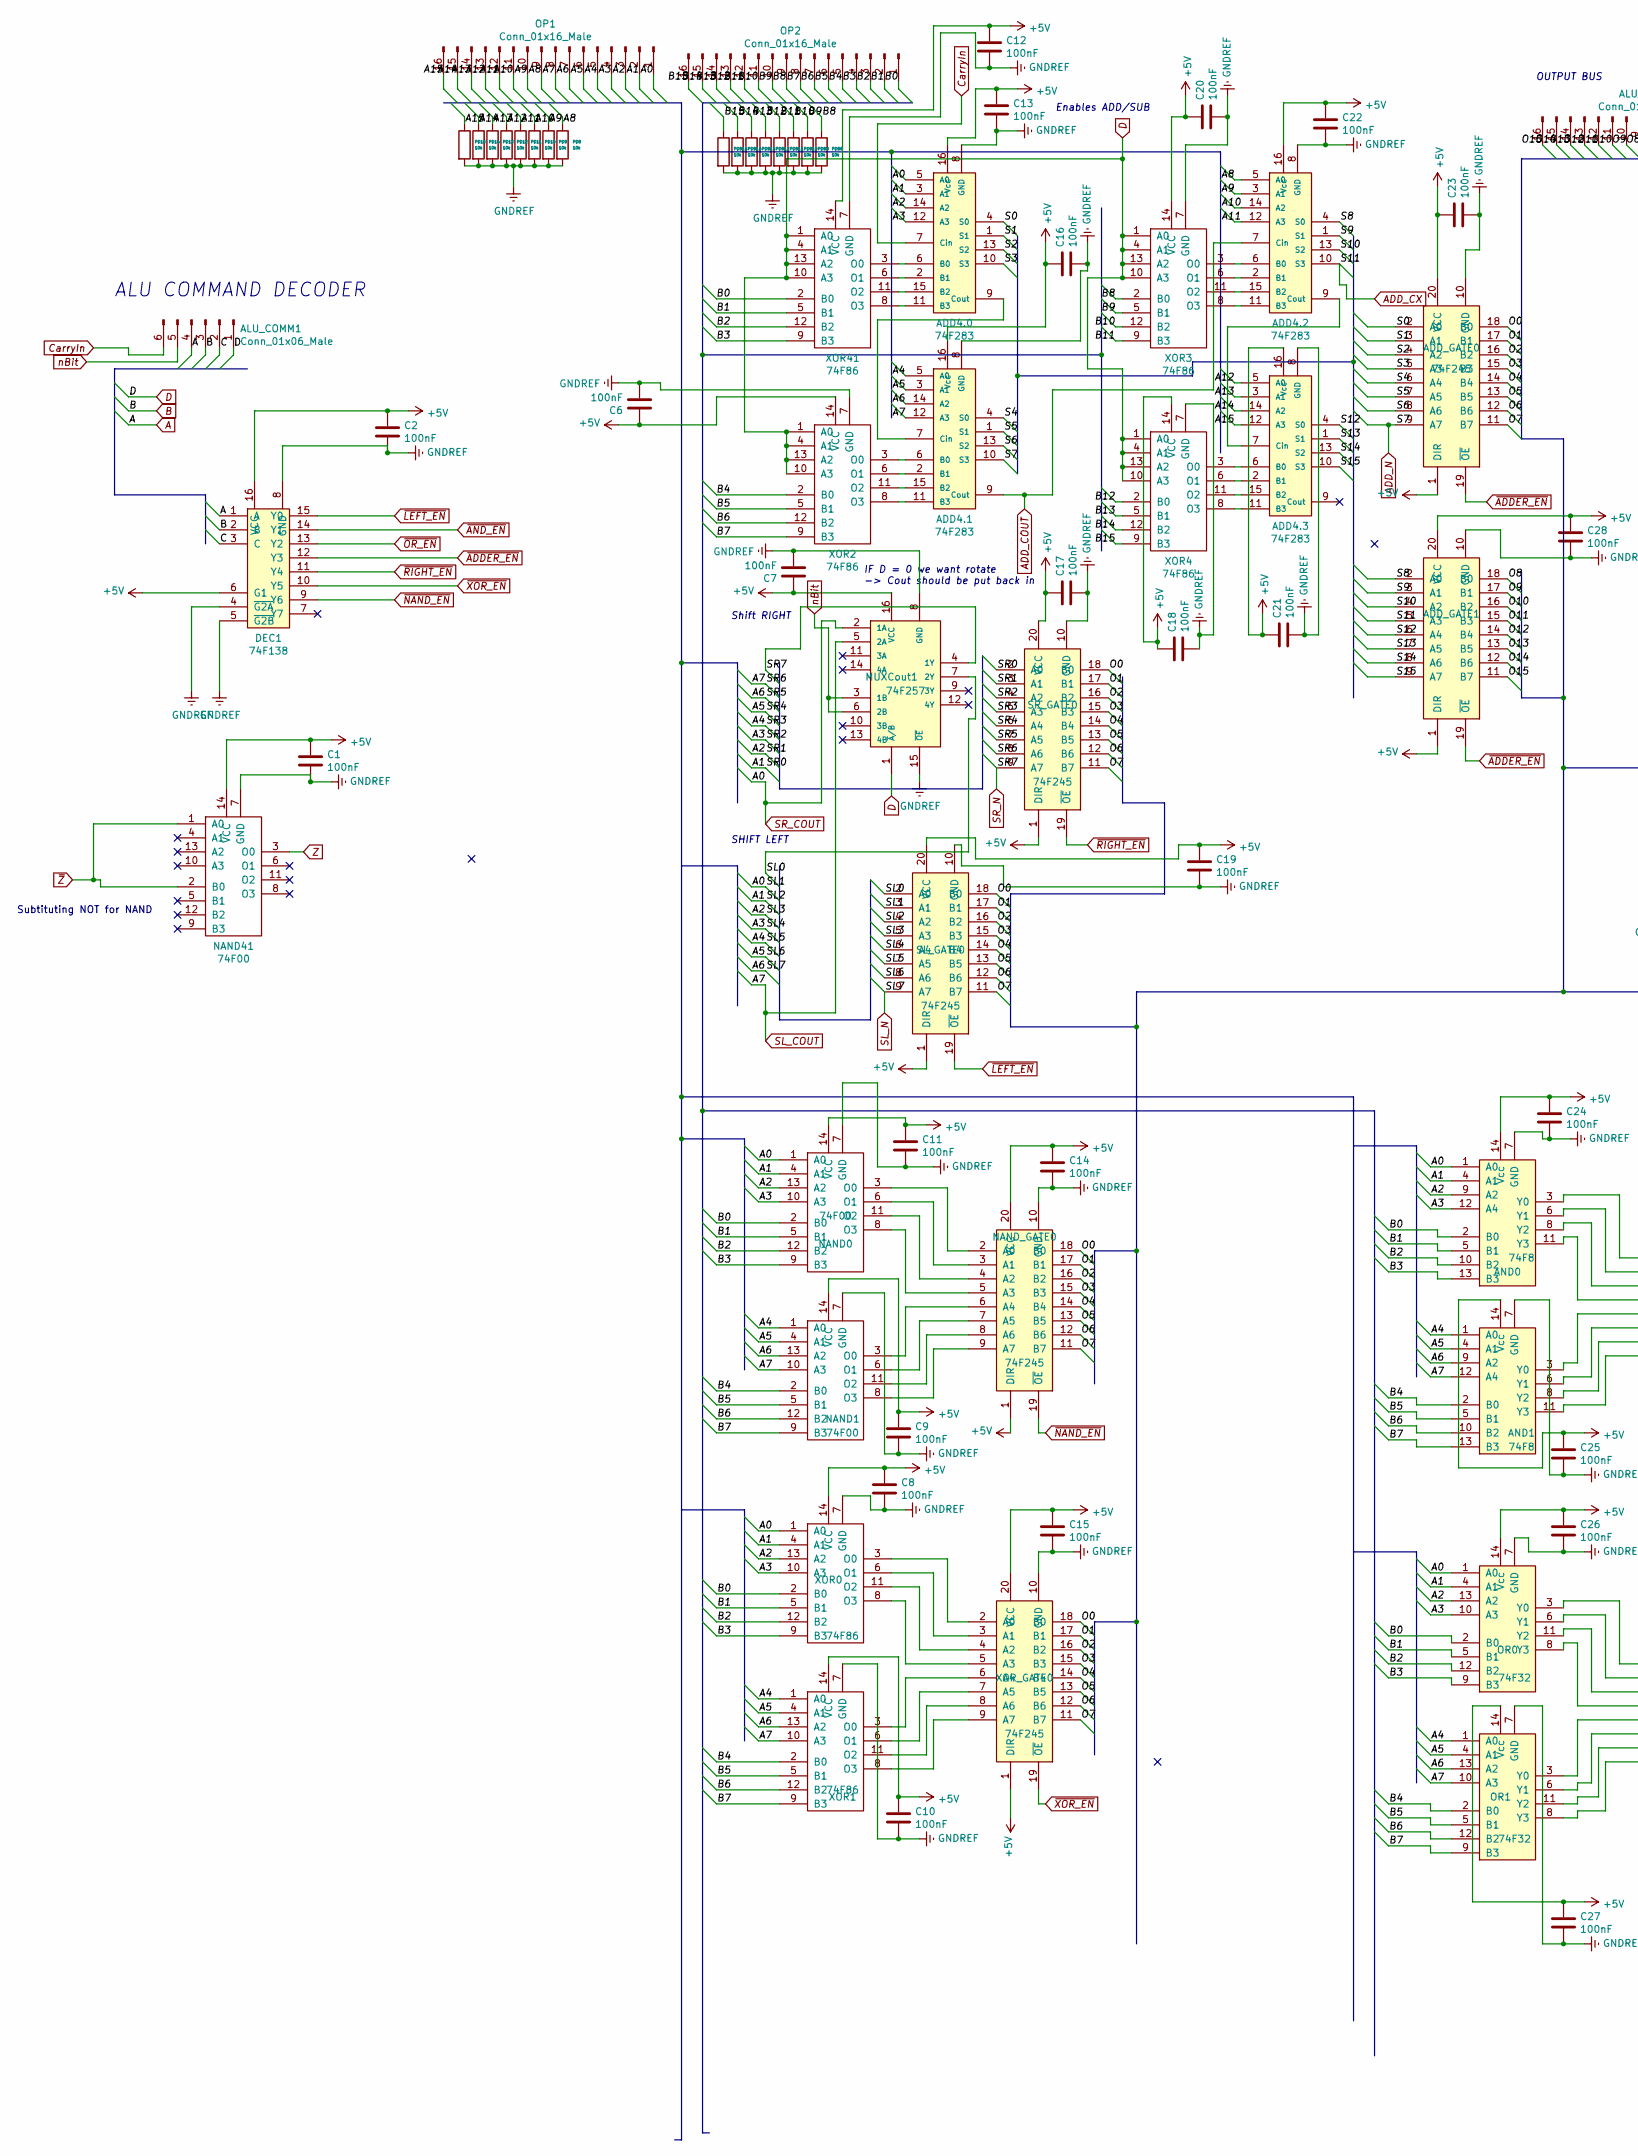
[picture p19: schematic ALU.sch, TinyRISC ALU, part in row 1, column 1]

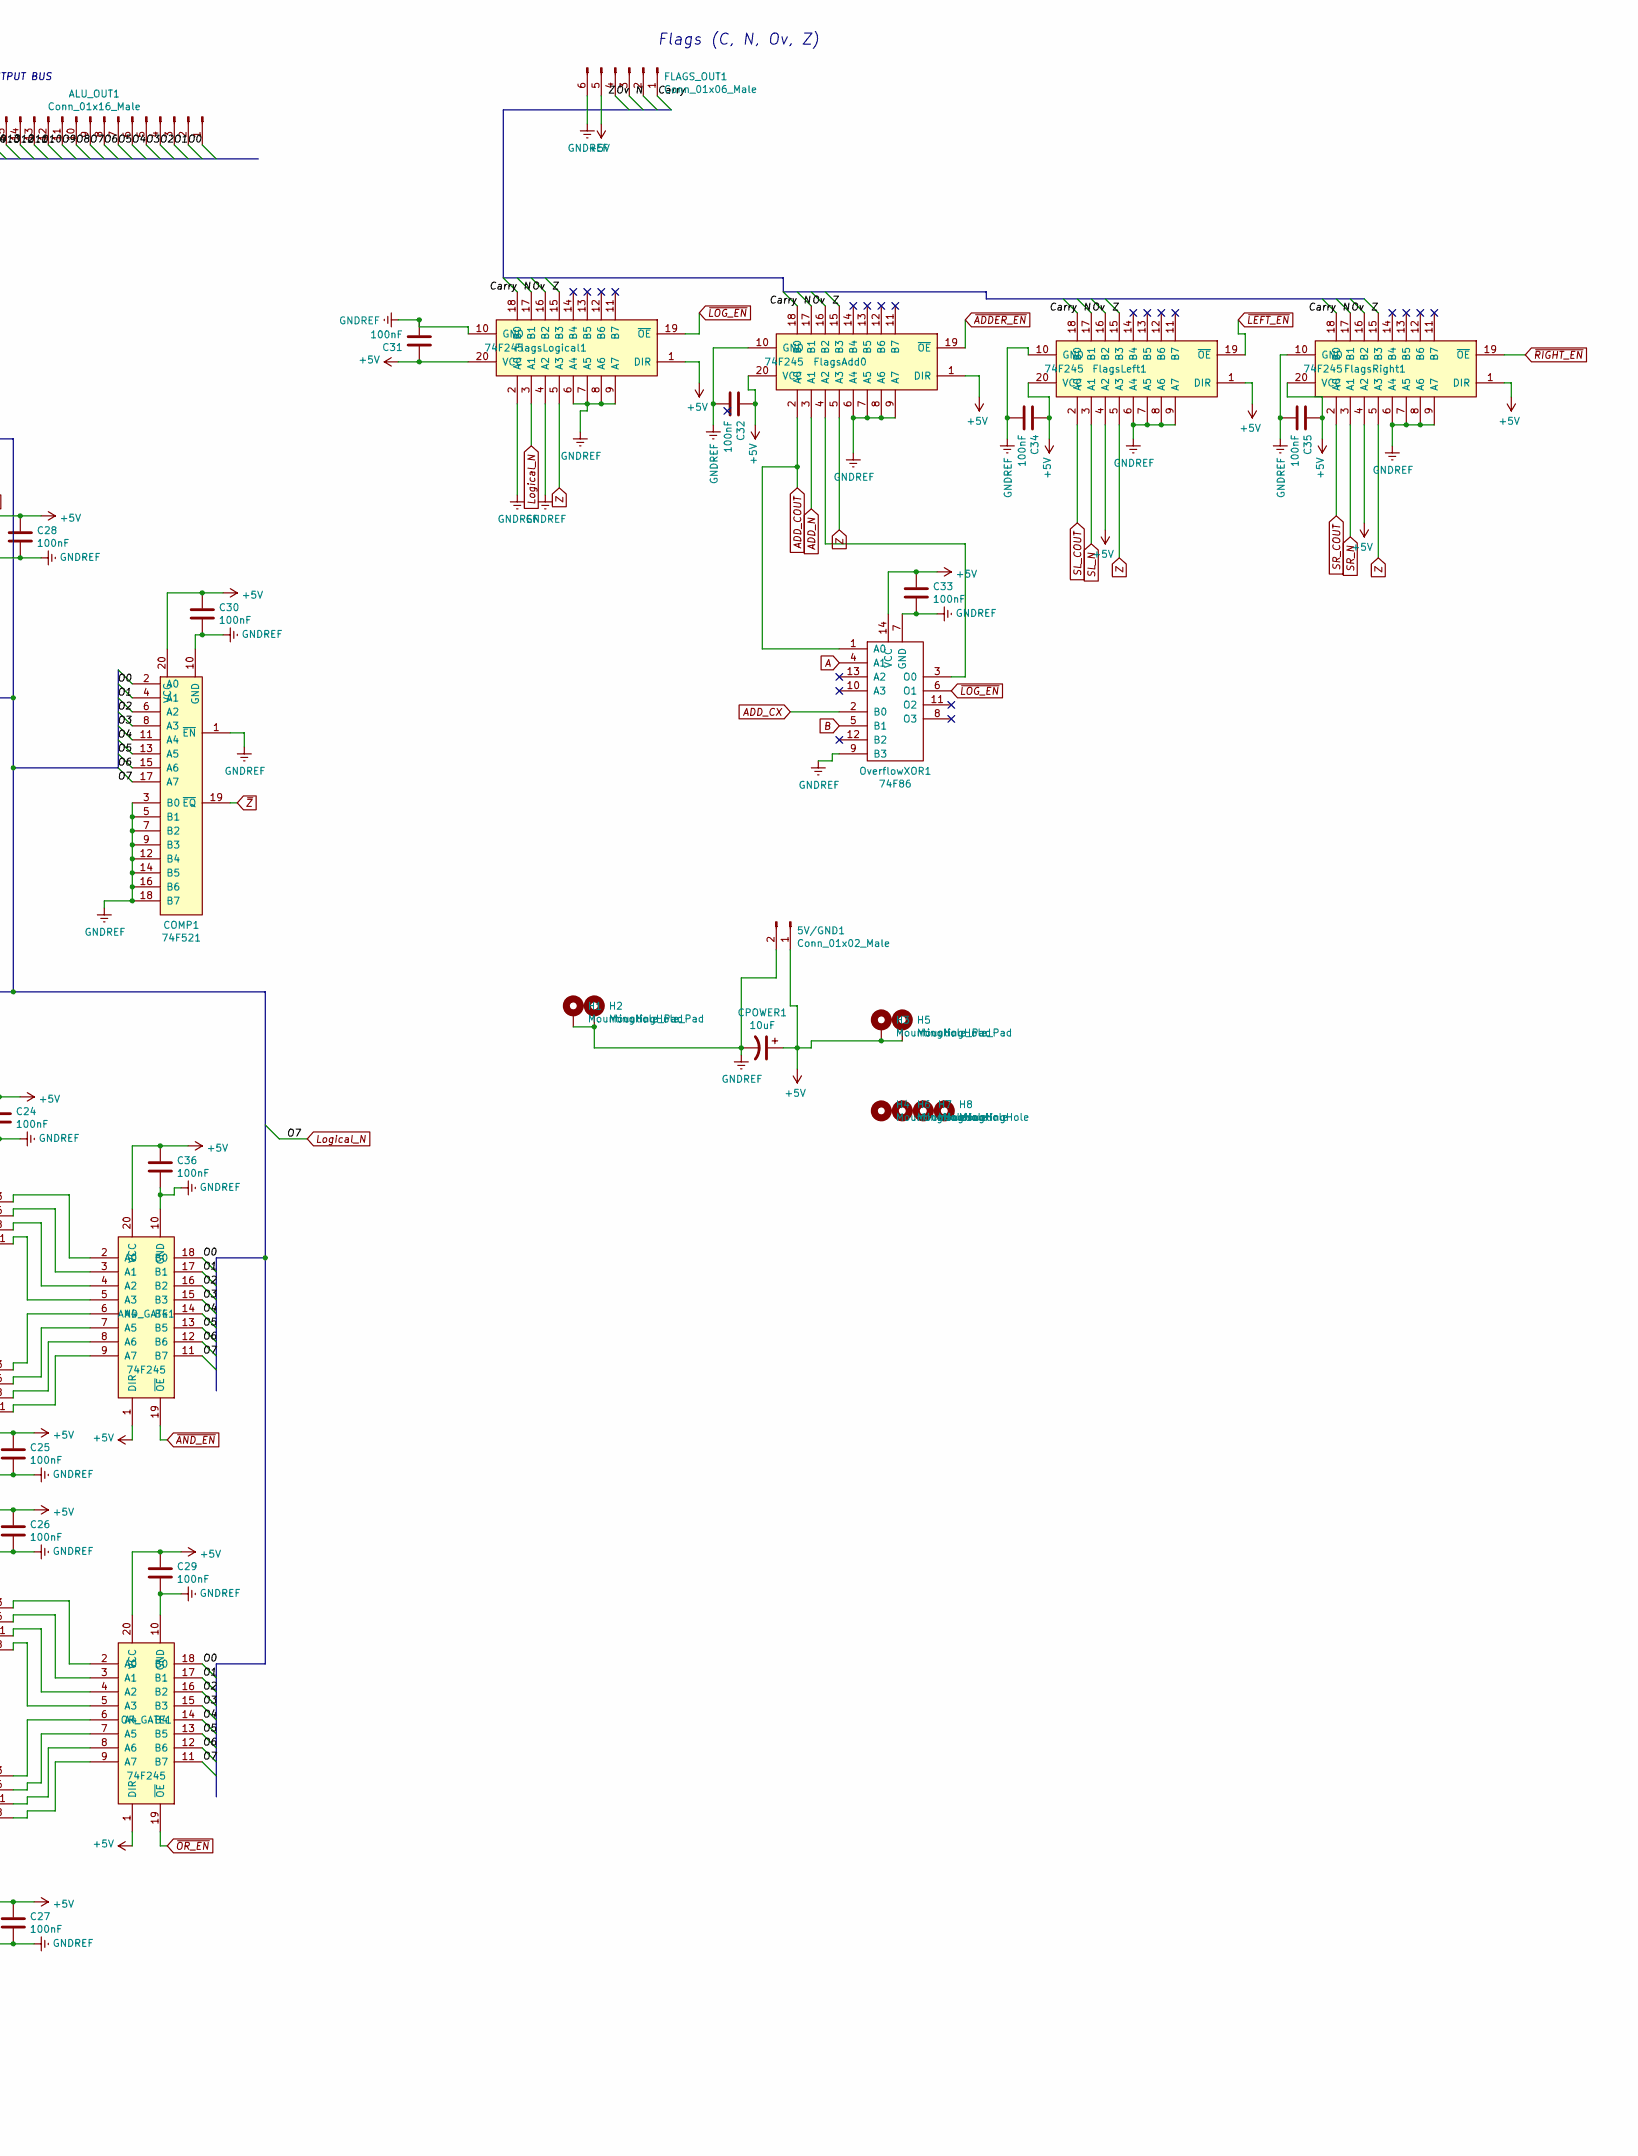
[picture p20: schematic ALU.sch, TinyRISC ALU, part in row 1, column 2]

Parts:
5V/GND1: Conn_01x02_Male; JST_XH_B2B-XH-AM_1x02_P2.50mm_Vertical
ADD4.0, ADD4.1, ADD4.2, ADD4.3: 74F283; DIP-16_W7.62mm
ADD_GATE0, ADD_GATE1: 74F245; DIP-20_W7.62mm
ALU_COMM1: Conn_01x06_Male; 6pinIDC
ALU_OUT1: Conn_01x16_Male; 16pinIDC
AND0, AND1: 74F8; DIP-14_W7.62mm
AND_GATE1: 74F245; DIP-20_W7.62mm
C1, C2, C6, C7, C8, C9, C10, C11, C12, C13, C14, C15, C16, C17, C18, C19, C20, C21, C22, C23, C24, C25, C26, C27, C28, C29, C30, C31, C32, C33, C34, C35, C36: 100nF; C_Axial_L5.1mm_D3.1mm_P7.50mm_Horizontal
COMP1: 74F521; DIP-20_W7.62mm
CPOWER1: 10uF; CP_Radial_D8.0mm_P2.50mm
DEC1: 74F138; DIP-16_W7.62mm
FLAGS_OUT1: Conn_01x06_Male; 6pinIDC
FlagsAdd0: 74F245; DIP-20_W7.62mm
FlagsLeft1: 74F245; DIP-20_W7.62mm
FlagsLogical1: 74F245; DIP-20_W7.62mm
FlagsRight1: 74F245; DIP-20_W7.62mm
H1, H2, H3, H5: MountingHole_Pad; MountingHole_3.5mm_Pad_Via
H4, H6, H7, H8: MountingHole; MountingHole_3.5mm_Pad_Via
MUXCout1: 74F257; DIP-16_W7.62mm
NAND0, NAND1, NAND41: 74F00; DIP-14_W7.62mm
NAND_GATE0: 74F245; DIP-20_W7.62mm
OP1, OP2: Conn_01x16_Male; 16pinIDC
OR0, OR1: 74F32; DIP-14_W7.62mm
OR_GATE1: 74F245; DIP-20_W7.62mm
OverflowXOR1: 74F86; DIP-14_W7.62mm
PD8, PD9, PD10, PD11, PD12, PD13, PD14, PD15: 10k; R_Axial_DIN0204_L3.6mm_D1.6mm_P7.62mm_Horizontal
PDB8, PDB9, PDB10, PDB11, PDB12, PDB13, PDB14, PDB15: 10k; R_Axial_DIN0204_L3.6mm_D1.6mm_P7.62mm_Horizontal
SL_GATE0: 74F245; DIP-20_W7.62mm
SR_GATE0: 74F245; DIP-20_W7.62mm
XOR0, XOR1, XOR2, XOR3, XOR4, XOR41: 74F86; DIP-14_W7.62mm
XOR_GATE0: 74F245; DIP-20_W7.62mm

Connections:
+5V: 5V/GND1.1, ADD4.0.16 (Vcc), ADD4.1.16 (Vcc), ADD4.2.16 (Vcc), ADD4.3.16 (Vcc), ADD_GATE0.1 (DIR), ADD_GATE0.20 (VCC), ADD_GATE1.1 (DIR), ADD_GATE1.20 (VCC), AND0.14 (Vcc), AND1.14 (Vcc), AND_GATE1.1 (DIR), AND_GATE1.20 (VCC), C1.1, C2.1, C6.1, C7.1, C8.1, C9.1, C10.1, C11.1, C12.1, C13.1, C14.1, C15.1, C16.1, C17.1, C18.1, C19.1, C20.1, C21.1, C22.1, C23.1, C24.1, C25.1, C26.1, C27.1, C28.1, C29.1, C30.1, C31.1, C32.1, C33.1, C34.1, C35.1, C36.1, COMP1.20 (VCC), CPOWER1.1, DEC1.6 (G1), DEC1.16 (VCC), FLAGS_OUT1.5, FlagsAdd0.1 (DIR), FlagsAdd0.20 (VCC), FlagsLeft1.1 (DIR), FlagsLeft1.4 (A2), FlagsLeft1.20 (VCC), FlagsLogical1.1 (DIR), FlagsLogical1.20 (VCC), FlagsRight1.1 (DIR), FlagsRight1.4 (A2), FlagsRight1.20 (VCC), H3.1, H5.1, MUXCout1.16 (VCC), NAND0.14 (VCC), NAND1.14 (VCC), NAND41.14 (VCC), NAND_GATE0.1 (DIR), NAND_GATE0.20 (VCC), OR0.14 (Vcc), OR1.14 (Vcc), OR_GATE1.1 (DIR), OR_GATE1.20 (VCC), OverflowXOR1.14 (VCC), SL_GATE0.1 (DIR), SL_GATE0.20 (VCC), SR_GATE0.1 (DIR), SR_GATE0.20 (VCC), XOR0.14 (VCC), XOR1.14 (VCC), XOR2.14 (VCC), XOR3.14 (VCC), XOR4.14 (VCC), XOR41.14 (VCC), XOR_GATE0.1 (DIR), XOR_GATE0.20 (VCC)
/A1: ADD4.0.3 (A1), AND0.4 (A1), NAND0.4 (A1), OP1.2, OR0.4 (A1), SL_GATE0.4 (A2), SR_GATE0.2 (A0), XOR0.4 (A1)
/A2: ADD4.0.14 (A2), AND0.9 (A2), NAND0.13 (A2), OP1.3, OR0.13 (A2), SL_GATE0.5 (A3), SR_GATE0.3 (A1), XOR0.13 (A2)
/A3: ADD4.0.12 (A3), AND0.12 (A4), NAND0.10 (A3), OP1.4, OR0.10 (A3), SL_GATE0.6 (A4), SR_GATE0.4 (A2), XOR0.10 (A3)
/A4: ADD4.1.5 (A0), AND1.1 (A0), NAND1.1 (A0), OP1.5, OR1.1 (A0), SL_GATE0.7 (A5), SR_GATE0.5 (A3), XOR1.1 (A0)
/A5: ADD4.1.3 (A1), AND1.4 (A1), NAND1.4 (A1), OP1.6, OR1.4 (A1), SL_GATE0.8 (A6), SR_GATE0.6 (A4), XOR1.4 (A1)
/A8: ADD4.2.5 (A0), OP1.9, PD8.1
/A9: ADD4.2.3 (A1), OP1.10, PD9.1
/A10: ADD4.2.14 (A2), OP1.11, PD10.1
/A11: ADD4.2.12 (A3), OP1.12, PD11.1
/A12: ADD4.3.5 (A0), OP1.13, PD12.1
/A13: ADD4.3.3 (A1), OP1.14, PD13.1
/A14: ADD4.3.14 (A2), OP1.15, PD14.1
/A15: ADD4.3.12 (A3), OP1.16, PD15.1
/B0: AND0.2 (B0), NAND0.2 (B0), OP2.1, OR0.2 (B0), XOR0.2 (B0), XOR41.2 (B0)
/B1: AND0.5 (B1), NAND0.5 (B1), OP2.2, OR0.5 (B1), XOR0.5 (B1), XOR41.5 (B1)
/B2: AND0.10 (B2), NAND0.12 (B2), OP2.3, OR0.12 (B2), XOR0.12 (B2), XOR41.12 (B2)
/B3: AND0.13 (B3), NAND0.9 (B3), OP2.4, OR0.9 (B3), XOR0.9 (B3), XOR41.9 (B3)
/B4: AND1.2 (B0), NAND1.2 (B0), OP2.5, OR1.2 (B0), XOR1.2 (B0), XOR2.2 (B0)
/B5: AND1.5 (B1), NAND1.5 (B1), OP2.6, OR1.5 (B1), XOR1.5 (B1), XOR2.5 (B1)
/B6: AND1.10 (B2), NAND1.12 (B2), OP2.7, OR1.12 (B2), XOR1.12 (B2), XOR2.12 (B2)
/B7: AND1.13 (B3), NAND1.9 (B3), OP2.8, OR1.9 (B3), XOR1.9 (B3), XOR2.9 (B3)
/B8: OP2.9, PDB8.1, XOR3.2 (B0)
/B9: OP2.10, PDB9.1, XOR3.5 (B1)
/B10: OP2.11, PDB10.1, XOR3.12 (B2)
/B11: OP2.12, PDB11.1, XOR3.9 (B3)
/B12: OP2.13, PDB12.1, XOR4.2 (B0)
/B13: OP2.14, PDB13.1, XOR4.5 (B1)
/B14: OP2.15, PDB14.1, XOR4.12 (B2)
/B15: OP2.16, PDB15.1, XOR4.9 (B3)
/C: ALU_COMM1.2, DEC1.3 (C)
/Carry: FLAGS_OUT1.1, FlagsAdd0.18 (B0), FlagsLeft1.18 (B0), FlagsLogical1.18 (B0), FlagsRight1.18 (B0)
/N: FLAGS_OUT1.2, FlagsAdd0.17 (B1), FlagsLeft1.17 (B1), FlagsLogical1.17 (B1), FlagsRight1.17 (B1)
/O0: ADD_GATE0.18 (B0), ALU_OUT1.1, AND_GATE1.18 (B0), COMP1.2 (A0), NAND_GATE0.18 (B0), OR_GATE1.18 (B0), SL_GATE0.18 (B0), SR_GATE0.18 (B0), XOR_GATE0.18 (B0)
/O1: ADD_GATE0.17 (B1), ALU_OUT1.2, AND_GATE1.17 (B1), COMP1.4 (A1), NAND_GATE0.17 (B1), OR_GATE1.17 (B1), SL_GATE0.17 (B1), SR_GATE0.17 (B1), XOR_GATE0.17 (B1)
/O2: ADD_GATE0.16 (B2), ALU_OUT1.3, AND_GATE1.16 (B2), COMP1.6 (A2), NAND_GATE0.16 (B2), OR_GATE1.16 (B2), SL_GATE0.16 (B2), SR_GATE0.16 (B2), XOR_GATE0.16 (B2)
/O3: ADD_GATE0.15 (B3), ALU_OUT1.4, AND_GATE1.15 (B3), COMP1.8 (A3), NAND_GATE0.15 (B3), OR_GATE1.15 (B3), SL_GATE0.15 (B3), SR_GATE0.15 (B3), XOR_GATE0.15 (B3)
/O4: ADD_GATE0.14 (B4), ALU_OUT1.5, AND_GATE1.14 (B4), COMP1.11 (A4), NAND_GATE0.14 (B4), OR_GATE1.14 (B4), SL_GATE0.14 (B4), SR_GATE0.14 (B4), XOR_GATE0.14 (B4)
/O5: ADD_GATE0.13 (B5), ALU_OUT1.6, AND_GATE1.13 (B5), COMP1.13 (A5), NAND_GATE0.13 (B5), OR_GATE1.13 (B5), SL_GATE0.13 (B5), SR_GATE0.13 (B5), XOR_GATE0.13 (B5)
/O6: ADD_GATE0.12 (B6), ALU_OUT1.7, AND_GATE1.12 (B6), COMP1.15 (A6), NAND_GATE0.12 (B6), OR_GATE1.12 (B6), SL_GATE0.12 (B6), SR_GATE0.12 (B6), XOR_GATE0.12 (B6)
/O8: ADD_GATE1.18 (B0), ALU_OUT1.9
/O9: ADD_GATE1.17 (B1), ALU_OUT1.10
/O10: ADD_GATE1.16 (B2), ALU_OUT1.11
/O11: ADD_GATE1.15 (B3), ALU_OUT1.12
/O12: ADD_GATE1.14 (B4), ALU_OUT1.13
/O13: ADD_GATE1.13 (B5), ALU_OUT1.14
/O14: ADD_GATE1.12 (B6), ALU_OUT1.15
/O15: ADD_GATE1.11 (B7), ALU_OUT1.16
/Ov: FLAGS_OUT1.3, FlagsAdd0.16 (B2), FlagsLeft1.16 (B2), FlagsLogical1.16 (B2), FlagsRight1.16 (B2)
/S0: ADD4.0.4 (S0), ADD_GATE0.2 (A0)
/S1: ADD4.0.1 (S1), ADD_GATE0.3 (A1)
/S2: ADD4.0.13 (S2), ADD_GATE0.4 (A2)
/S3: ADD4.0.10 (S3), ADD_GATE0.5 (A3)
/S4: ADD4.1.4 (S0), ADD_GATE0.6 (A4)
/S5: ADD4.1.1 (S1), ADD_GATE0.7 (A5)
/S6: ADD4.1.13 (S2), ADD_GATE0.8 (A6)
/S8: ADD4.2.4 (S0), ADD_GATE1.2 (A0)
/S9: ADD4.2.1 (S1), ADD_GATE1.3 (A1)
/S10: ADD4.2.13 (S2), ADD_GATE1.4 (A2)
/S12: ADD4.3.4 (S0), ADD_GATE1.6 (A4)
/S13: ADD4.3.1 (S1), ADD_GATE1.7 (A5)
/S14: ADD4.3.13 (S2), ADD_GATE1.8 (A6)
/S15: ADD4.3.10 (S3), ADD_GATE1.9 (A7)
/SL0: MUXCout1.7 (2Y), SL_GATE0.2 (A0)
A: ALU_COMM1.4, DEC1.1 (A), OverflowXOR1.4 (A1)
ADD_COUT: ADD4.1.9 (Cout), ADD4.2.7 (Cin), FlagsAdd0.2 (A0), OverflowXOR1.1 (A0)
ADD_CX: ADD4.2.10 (S3), ADD_GATE1.5 (A3), OverflowXOR1.2 (B0)
ADD_N: ADD4.1.10 (S3), ADD_GATE0.9 (A7), FlagsAdd0.3 (A1)
B: ALU_COMM1.3, DEC1.2 (B), OverflowXOR1.5 (B1)
CarryIn: ADD4.0.7 (Cin), ALU_COMM1.6
D: ALU_COMM1.1, MUXCout1.1 (~A~/B), XOR2.1 (A0), XOR2.4 (A1), XOR2.10 (A3), XOR2.13 (A2), XOR3.1 (A0), XOR3.4 (A1), XOR3.10 (A3), XOR3.13 (A2), XOR4.1 (A0), XOR4.4 (A1), XOR4.10 (A3), XOR4.13 (A2), XOR41.1 (A0), XOR41.4 (A1), XOR41.10 (A3), XOR41.13 (A2)
GNDREF: 5V/GND1.2, ADD4.0.8 (GND), ADD4.1.8 (GND), ADD4.2.8 (GND), ADD4.3.8 (GND), ADD_GATE0.10 (GND), ADD_GATE1.10 (GND), AND0.7 (GND), AND1.7 (GND), AND_GATE1.10 (GND), C1.2, C2.2, C6.2, C7.2, C8.2, C9.2, C10.2, C11.2, C12.2, C13.2, C14.2, C15.2, C16.2, C17.2, C18.2, C19.2, C20.2, C21.2, C22.2, C23.2, C24.2, C25.2, C26.2, C27.2, C28.2, C29.2, C30.2, C31.2, C32.2, C33.2, C34.2, C35.2, C36.2, COMP1.1 (~EN), COMP1.3 (B0), COMP1.5 (B1), COMP1.7 (B2), COMP1.9 (B3), COMP1.10 (GND), COMP1.12 (B4), COMP1.14 (B5), COMP1.16 (B6), COMP1.18 (B7), CPOWER1.2, DEC1.4 (~G2A), DEC1.5 (~G2B), DEC1.8 (GND), FLAGS_OUT1.6, FlagsAdd0.6 (A4), FlagsAdd0.7 (A5), FlagsAdd0.8 (A6), FlagsAdd0.9 (A7), FlagsAdd0.10 (GND), FlagsLeft1.6 (A4), FlagsLeft1.7 (A5), FlagsLeft1.8 (A6), FlagsLeft1.9 (A7), FlagsLeft1.10 (GND), FlagsLogical1.2 (A0), FlagsLogical1.4 (A2), FlagsLogical1.6 (A4), FlagsLogical1.7 (A5), FlagsLogical1.8 (A6), FlagsLogical1.9 (A7), FlagsLogical1.10 (GND), FlagsRight1.6 (A4), FlagsRight1.7 (A5), FlagsRight1.8 (A6), FlagsRight1.9 (A7), FlagsRight1.10 (GND), H1.1, H2.1, MUXCout1.8 (GND), MUXCout1.15 (~OE), NAND0.7 (GND), NAND1.7 (GND), NAND41.7 (GND), NAND_GATE0.10 (GND), OR0.7 (GND), OR1.7 (GND), OR_GATE1.10 (GND), OverflowXOR1.7 (GND), OverflowXOR1.9 (B3), PD8.2, PD9.2, PD10.2, PD11.2, PD12.2, PD13.2, PD14.2, PD15.2, PDB8.2, PDB9.2, PDB10.2, PDB11.2, PDB12.2, PDB13.2, PDB14.2, PDB15.2, SL_GATE0.10 (GND), SR_GATE0.10 (GND), XOR0.7 (GND), XOR1.7 (GND), XOR2.7 (GND), XOR3.7 (GND), XOR4.7 (GND), XOR41.7 (GND), XOR_GATE0.10 (GND)
Logical_N: ADD_GATE0.11 (B7), ALU_OUT1.8, AND_GATE1.11 (B7), COMP1.17 (A7), FlagsLogical1.3 (A1), NAND_GATE0.11 (B7), OR_GATE1.11 (B7), SL_GATE0.11 (B7), SR_GATE0.11 (B7), XOR_GATE0.11 (B7)
unnamed: ADD4.0.2 (B1), XOR41.6 (O1)
unnamed: ADD4.0.6 (B0), XOR41.3 (O0)
unnamed: ADD4.0.9 (Cout), ADD4.1.7 (Cin)
unnamed: ADD4.0.11 (B3), XOR41.8 (O3)
unnamed: ADD4.0.15 (B2), XOR41.11 (O2)
unnamed: ADD4.1.2 (B1), XOR2.6 (O1)
unnamed: ADD4.1.6 (B0), XOR2.3 (O0)
unnamed: ADD4.1.11 (B3), XOR2.8 (O3)
unnamed: ADD4.1.15 (B2), XOR2.11 (O2)
unnamed: ADD4.2.2 (B1), XOR3.6 (O1)
unnamed: ADD4.2.6 (B0), XOR3.3 (O0)
unnamed: ADD4.2.9 (Cout), ADD4.3.7 (Cin)
unnamed: ADD4.2.11 (B3), XOR3.8 (O3)
unnamed: ADD4.2.15 (B2), XOR3.11 (O2)
unnamed: ADD4.3.2 (B1), XOR4.6 (O1)
unnamed: ADD4.3.6 (B0), XOR4.3 (O0)
unnamed: ADD4.3.11 (B3), XOR4.8 (O3)
unnamed: ADD4.3.15 (B2), XOR4.11 (O2)
unnamed: AND0.3 (Y0), AND_GATE1.2 (A0)
unnamed: AND0.6 (Y1), AND_GATE1.3 (A1)
unnamed: AND0.8 (Y2), AND_GATE1.4 (A2)
unnamed: AND0.11 (Y3), AND_GATE1.5 (A3)
unnamed: AND1.3 (Y0), AND_GATE1.6 (A4)
unnamed: AND1.6 (Y1), AND_GATE1.7 (A5)
unnamed: AND1.8 (Y2), AND_GATE1.8 (A6)
unnamed: AND1.11 (Y3), AND_GATE1.9 (A7)
unnamed: FlagsAdd0.4 (A2), OverflowXOR1.3 (O0)
unnamed: NAND0.3 (O0), NAND_GATE0.2 (A0)
unnamed: NAND0.6 (O1), NAND_GATE0.3 (A1)
unnamed: NAND0.8 (O3), NAND_GATE0.5 (A3)
unnamed: NAND0.11 (O2), NAND_GATE0.4 (A2)
unnamed: NAND1.3 (O0), NAND_GATE0.6 (A4)
unnamed: NAND1.6 (O1), NAND_GATE0.7 (A5)
unnamed: NAND1.8 (O3), NAND_GATE0.9 (A7)
unnamed: NAND1.11 (O2), NAND_GATE0.8 (A6)
unnamed: OR0.3 (Y0), OR_GATE1.2 (A0)
unnamed: OR0.6 (Y1), OR_GATE1.3 (A1)
unnamed: OR0.8 (Y3), OR_GATE1.5 (A3)
unnamed: OR0.11 (Y2), OR_GATE1.4 (A2)
unnamed: OR1.3 (Y0), OR_GATE1.6 (A4)
unnamed: OR1.6 (Y1), OR_GATE1.7 (A5)
unnamed: OR1.8 (Y3), OR_GATE1.9 (A7)
unnamed: OR1.11 (Y2), OR_GATE1.8 (A6)
unnamed: XOR0.3 (O0), XOR_GATE0.2 (A0)
unnamed: XOR0.6 (O1), XOR_GATE0.3 (A1)
unnamed: XOR0.8 (O3), XOR_GATE0.5 (A3)
unnamed: XOR0.11 (O2), XOR_GATE0.4 (A2)
unnamed: XOR1.3 (O0), XOR_GATE0.6 (A4)
unnamed: XOR1.6 (O1), XOR_GATE0.7 (A5)
unnamed: XOR1.8 (O3), XOR_GATE0.9 (A7)
unnamed: XOR1.11 (O2), XOR_GATE0.8 (A6)
SL_COUT: ADD4.1.12 (A3), AND1.12 (A4), FlagsLeft1.2 (A0), MUXCout1.5 (2A), NAND1.10 (A3), OP1.8, OR1.10 (A3), SR_GATE0.8 (A6), XOR1.10 (A3)
SL_N: ADD4.1.14 (A2), AND1.9 (A2), FlagsLeft1.3 (A1), NAND1.13 (A2), OP1.7, OR1.13 (A2), SL_GATE0.9 (A7), SR_GATE0.7 (A5), XOR1.13 (A2)
SR_COUT: ADD4.0.5 (A0), AND0.1 (A0), FlagsRight1.2 (A0), MUXCout1.2 (1A), NAND0.1 (A0), OP1.1, OR0.1 (A0), SL_GATE0.3 (A1), XOR0.1 (A0)
SR_N: FlagsRight1.3 (A1), MUXCout1.4 (1Y), SR_GATE0.9 (A7)
Z: FLAGS_OUT1.4, FlagsAdd0.5 (A3), FlagsAdd0.15 (B3), FlagsLeft1.5 (A3), FlagsLeft1.15 (B3), FlagsLogical1.5 (A3), FlagsLogical1.15 (B3), FlagsRight1.5 (A3), FlagsRight1.15 (B3), NAND41.3 (O0)
nBit: ALU_COMM1.5, MUXCout1.3 (1B), MUXCout1.6 (2B)
~ADDER_EN: ADD_GATE0.19 (~OE), ADD_GATE1.19 (~OE), DEC1.12 (Y3), FlagsAdd0.19 (~OE)
~AND_EN: AND_GATE1.19 (~OE), DEC1.14 (Y1)
~LEFT_EN: DEC1.15 (Y0), FlagsLeft1.19 (~OE), SL_GATE0.19 (~OE)
~LOG_EN: FlagsLogical1.19 (~OE), OverflowXOR1.6 (O1)
~NAND_EN: DEC1.9 (Y6), NAND_GATE0.19 (~OE)
~OR_EN: DEC1.13 (Y2), OR_GATE1.19 (~OE)
~RIGHT_EN: DEC1.11 (Y4), FlagsRight1.19 (~OE), SR_GATE0.19 (~OE)
~XOR_EN: DEC1.10 (Y5), XOR_GATE0.19 (~OE)
~Z: COMP1.19 (~EQ), NAND41.1 (A0), NAND41.2 (B0)

Notes on the sheet:
ALU COMMAND DECODER
Enables ADD/SUB
Shift RIGHT
IF D = 0 we want rotate -> Cout should be put back in
SHIFT LEFT
OUTPUT BUS
Flags (C, N, Ov, Z)
Subtituting NOT for NAND

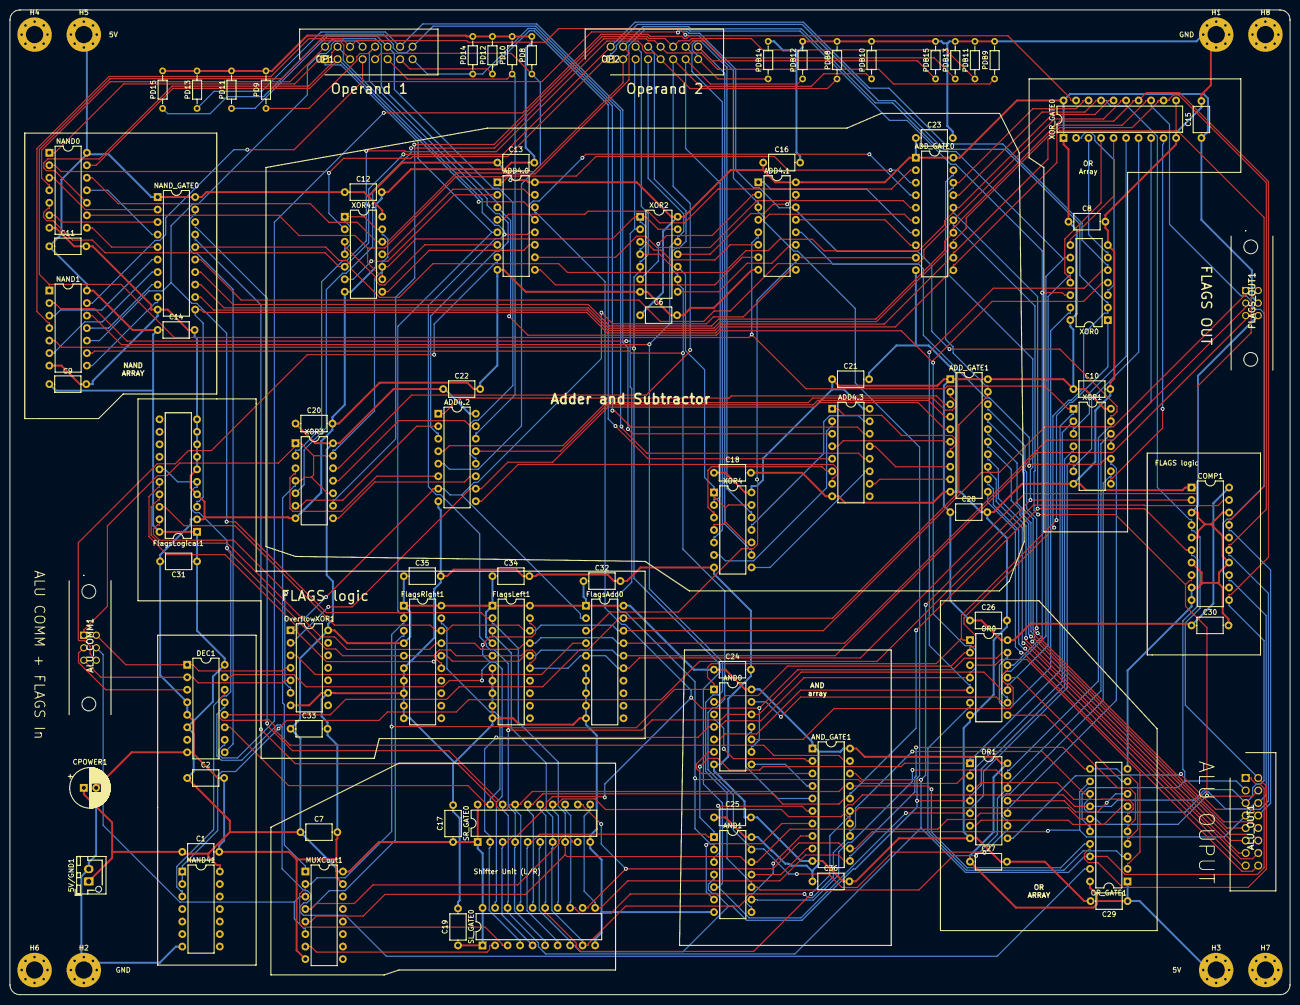
[picture p21: board ALU.kicad_pcb from above]

Board: 2 copper layers, 260.0 x 200.0 mm, 97 parts (0 on the bottom side), 139 nets.
