Lucboulesteix/TinyRISC/Program Counter/V1.0/Program Counter.kicad_pcb

## KiCad design Program Counter/V1.0/Program Counter.kicad_pcb (2021-10-27, an earlier design)

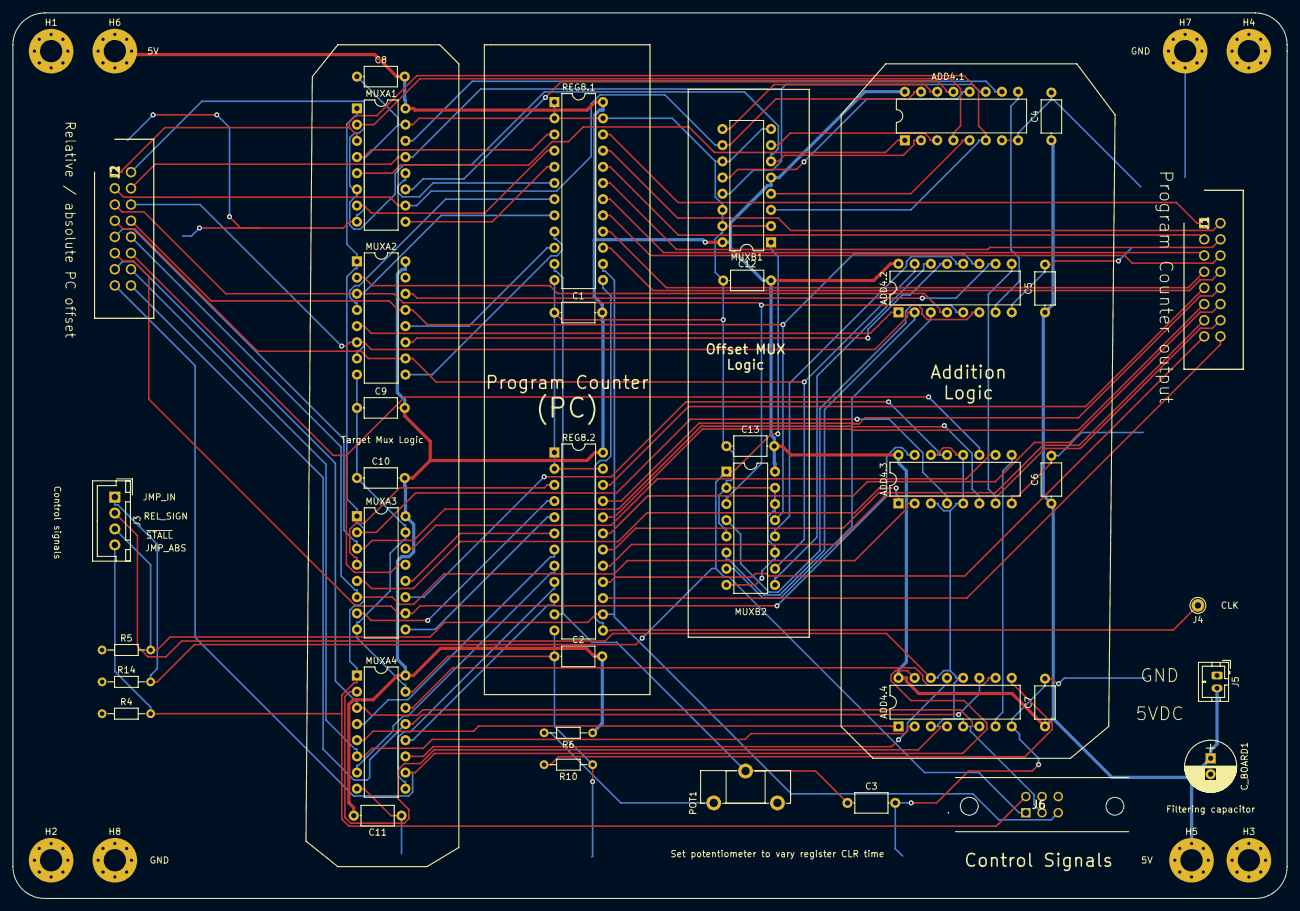
[picture p22: board Program Counter.kicad_pcb from above]

Board: 2 copper layers, 200.0 x 139.0 mm, 46 parts (0 on the bottom side), 85 nets.

Parts:
ADD4.1, ADD4.2, ADD4.3, ADD4.4: 74F283; DIP-16_W7.62mm
C1, C2, C4, C5, C6, C7, C8, C9, C11, C12, C13: 100nF; C_Axial_L5.1mm_D3.1mm_P7.50mm_Horizontal
C3: C?; C_Axial_L5.1mm_D3.1mm_P7.50mm_Horizontal
C10: 100nf; C_Axial_L5.1mm_D3.1mm_P7.50mm_Horizontal
C_BOARD1: 10uF; CP_Radial_D8.0mm_P2.50mm
H1, H2, H3, H4: MountingHole; MountingHole_3.5mm_Pad_Via
H5, H6, H7, H8: MountingHole_Pad; MountingHole_3.5mm_Pad_Via
J1: PC_OUT; 16pinIDC
J2: PC_OFFS; 16pinIDC
J3: Control; JST_XH_B04B-XH-A_04x2.50mm_Straight
J4: Clock; Pin_D1.0mm_L10.0mm
J5: POWER/GND; JST_PH_B2B-PH-K_1x02_P2.00mm_Vertical
J6: Control; 6pinIDC
MUXA1, MUXA2, MUXA3, MUXA4: 74F257; DIP-16_W7.62mm
MUXB1, MUXB2: 74F257; DIP-16_W7.62mm
POT1: 1K; Potentiometer_Trimmer_ACP_CA14h5_Vertical_Px5.0mm_Py10.0mm
R4, R5, R10, R14: 10K; R_Axial_DIN0204_L3.6mm_D1.6mm_P7.62mm_Horizontal
R6: 100; R_Axial_DIN0204_L3.6mm_D1.6mm_P7.62mm_Horizontal
REG8.1, REG8.2: 74F825; DIP-24_W7.62mm

Connections:
+5V: ADD4.1.16, ADD4.2.16, ADD4.3.16, ADD4.4.16, C1.2, C2.2, C4.1, C5.1, C6.1, C7.1, C8.2, C9.2, C10.2, C11.2, C12.2, C13.2, C_BOARD1.1, H5.1, H6.1, J5.2, MUXA1.16, MUXA2.16, MUXA3.16, MUXA4.16, MUXB1.5, MUXB1.16, MUXB2.16, R6.1, REG8.1.24, REG8.2.24
/N0: MUXA1.4, REG8.1.3
/N1: MUXA1.7, REG8.1.4
/N2: MUXA1.9, REG8.1.5
/N3: MUXA1.12, REG8.1.6
/N4: MUXA2.4, REG8.1.7
/N5: MUXA2.7, REG8.1.8
/N6: MUXA2.9, REG8.1.9
/N7: MUXA2.12, REG8.1.10
/N8: MUXA3.4, REG8.2.3
/N9: MUXA3.7, REG8.2.4
/N10: MUXA3.9, REG8.2.5
/N11: MUXA3.12, REG8.2.6
/N12: MUXA4.4, REG8.2.7
/N13: MUXA4.7, REG8.2.8
/N14: MUXA4.9, REG8.2.9
/N15: MUXA4.12, REG8.2.10
/O0: J1.1, REG8.1.22
/O1: J1.2, REG8.1.21
/O2: J1.3, REG8.1.20
/O3: J1.4, REG8.1.19
/O4: J1.5, REG8.1.18
/O5: J1.6, REG8.1.17
/O6: J1.7, REG8.1.16
/O7: J1.8, REG8.1.15
/O8: J1.9, REG8.2.22
/O9: J1.10, REG8.2.21
/O10: J1.11, REG8.2.20
/O11: J1.12, REG8.2.19
/O12: J1.13, REG8.2.18
/O13: J1.14, REG8.2.17
/O14: J1.15, REG8.2.16
/O15: J1.16, REG8.2.15
/OFF0: ADD4.1.6, J2.1, MUXA1.3, MUXB1.3
/OFF1: ADD4.1.2, J2.2, MUXA1.6, MUXB1.6
/OFF2: ADD4.1.15, J2.3, MUXA1.10, MUXB1.10
/OFF3: ADD4.1.11, J2.4, MUXA1.13, MUXB1.13
/OFF4: ADD4.2.6, J2.5, MUXA2.3, MUXB2.3
/OFF5: ADD4.2.2, J2.6, MUXA2.6, MUXB2.6
/OFF6: ADD4.2.15, J2.7, MUXA2.10, MUXB2.10
/OFF7: ADD4.2.11, J2.8, MUXA2.13, MUXB2.13
/OFF8: ADD4.3.6, J2.9, MUXA3.3
/OFF9: ADD4.3.2, J2.10, MUXA3.6
/OFF10: ADD4.3.15, J2.11, MUXA3.10
/OFF11: ADD4.3.11, J2.12, MUXA3.13
/OFF12: ADD4.4.6, J2.13, MUXA4.3
/OFF13: ADD4.4.2, J2.14, MUXA4.6
/OFF14: ADD4.4.15, J2.15, MUXA4.10
/OFF15: ADD4.4.11, J2.16, MUXA4.13
/R0: ADD4.1.5, MUXB1.4
/R1: ADD4.1.3, MUXB1.7
/R2: ADD4.1.14, MUXB1.9
/R3: ADD4.1.12, MUXB1.12
/R4: ADD4.2.5, MUXB2.4
/R5: ADD4.2.3, MUXB2.7
/R6: ADD4.2.14, MUXB2.9
/R7: ADD4.2.12, MUXB2.12
/S0: ADD4.1.4, MUXA1.2
/S1: ADD4.1.1, MUXA1.5
/S2: ADD4.1.13, MUXA1.11
/S3: ADD4.1.10, MUXA1.14
/S4: ADD4.2.4, MUXA2.2
/S5: ADD4.2.1, MUXA2.5
/S6: ADD4.2.13, MUXA2.11
/S7: ADD4.2.10, MUXA2.14
/S8: ADD4.3.4, MUXA3.2
/S9: ADD4.3.1, MUXA3.5
/S10: ADD4.3.13, MUXA3.11
/S11: ADD4.3.10, MUXA3.14
/S12: ADD4.4.4, MUXA4.2
/S13: ADD4.4.1, MUXA4.5
/S14: ADD4.4.13, MUXA4.11
/S15: ADD4.4.10, MUXA4.14
CLK: J4.1, REG8.1.13, REG8.2.13
GNDREF: ADD4.1.7, ADD4.1.8, ADD4.2.8, ADD4.3.8, ADD4.4.8, C1.1, C2.1, C3.2, C4.2, C5.2, C6.2, C7.2, C8.1, C9.1, C10.1, C11.1, C12.1, C13.1, C_BOARD1.2, H7.1, H8.1, J5.1, MUXA1.8, MUXA1.15, MUXA2.8, MUXA3.8, MUXA3.15, MUXA4.8, MUXA4.15, MUXB1.2, MUXB1.8, MUXB1.11, MUXB1.14, MUXB1.15, MUXB2.2, MUXB2.5, MUXB2.8, MUXB2.11, MUXB2.14, MUXB2.15, R4.1, R5.1, R10.1, R14.1, REG8.1.1, REG8.1.2, REG8.1.12, REG8.1.23, REG8.2.1, REG8.2.2, REG8.2.12, REG8.2.23
JMP_ABS: J3.4, J6.4, MUXA1.1, MUXA2.1, MUXA3.1, MUXA4.1, R4.2
JMP_IN: J3.1, J6.1, MUXB1.1, MUXB2.1, R14.2
unnamed: ADD4.1.9, ADD4.2.7
unnamed: ADD4.2.9, ADD4.3.7
unnamed: ADD4.3.9, ADD4.4.7
unnamed: ADD4.4.9, R10.2
unnamed: POT1.1, R6.2
REL_SIGN: ADD4.3.3, ADD4.3.5, ADD4.3.12, ADD4.3.14, ADD4.4.3, ADD4.4.5, ADD4.4.12, ADD4.4.14, J3.2, J6.2
~PC_CLR: C3.1, POT1.2, REG8.1.11, REG8.2.11
~STALL: J3.3, J6.3, R5.2, REG8.1.14, REG8.2.14
