Lucboulesteix/TinyRISC/(commit log)

2021-10-21 20oct
    Last progress on evening of October 20
    [Instruction syntax.ods, Program Counter.kicad_pcb, Program Counter.sch]
2021-10-27 27oct
    Finished v1.0 of ALU, PC and GP RF.
    Updated documentation to match.
    [ALU-B_Cu.gbr, ALU-B_Mask.gbr, ALU-B_Paste.gbr, ALU-B_SilkS.gbr, ALU-Edge_Cuts.gbr, ALU-F_Cu.gbr, ALU-F_Mask.gbr, ALU-F_Paste.gbr]
2021-11-02 02nov
    Updated documentation
    [BOM.xlsx, General Purpose RF BOM.csv, Instruction syntax.ods]
2021-11-07 08nov
    -Added to documentation
    -Started control signal tables
    -Started v1.1 of PC module
    [ALU.sch, Instruction syntax.ods, PC_BOM.csv, PC_BOM.xlsx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]
2021-11-11 11nov
    -finished ALU test program on arduino
    [Instruction syntax.ods]
